GP-Golden-9/GP/docs/design_notes/rplidar_a1m8_map_quality_report.md

# RPLIDAR A1M8 Map Quality Issues: Root Causes, Community Solutions & Best Practices

**Prepared for:** Robotics / ROS Developer  
**LiDAR Model:** Slamtec RPLIDAR A1M8  
**Scope:** 2D SLAM mapping, odometry integration, dashboard visualization  

---

## Executive Summary

The RPLIDAR A1M8 is a cost-effective 360° 2D laser scanner widely used in ROS-based robotics projects. However, users frequently encounter poor map quality — distorted walls, doubled lines, blurry or "melted" obstacles — especially when the generated map is loaded on a remote dashboard or a separate laptop. This report documents the root causes of these issues, the solutions successfully applied by the ROS community, and best practices for achieving high-quality, stable maps with the A1M8.

---

## 1. Hardware Specifications (A1M8)

Understanding hardware limits is critical before tuning software parameters[cite:16][cite:30].

| Parameter | Specification |
|---|---|
| Ranging Method | Laser Triangulation |
| Scan Rate | 5.5 Hz (default), configurable up to 10–16 Hz |
| Sample Frequency | ≥ 8,000 Hz |
| Angular Resolution | ≤ 1° |
| Distance Range | 0.15 – 12 m (R5 model); 0.15 – 6 m (R4 and below) |
| Ranging Accuracy | < 0.5 mm / < 1% of distance |
| Communication | UART / USB (via CP2102 adapter) |

The A1M8 has **no built-in odometry**. It outputs only raw scan (`/scan`) topic data[cite:16]. This is the single most important hardware constraint that causes poor map quality.

---

## 2. Root Causes of Poor Map Quality

### 2.1 Missing or Incorrect Odometry (Primary Cause)

All major SLAM algorithms except Hector SLAM require an odometry source published to `/odom`[cite:52]. When the robot moves and SLAM has no odometry reference, it cannot correctly stitch consecutive laser scans together. The result is:

- Walls that appear doubled or smeared
- Rooms that appear stretched or rotated
- Inconsistent overlap between scan sweeps

This is the most commonly reported issue in the ROS community with the A1M8[cite:43][cite:71]. The A1M8 ships without wheel encoders or an IMU, meaning that out of the box, there is zero odometry data unless the developer provides an external source or uses a SLAM algorithm that does not require it.

### 2.2 Incorrect TF (Transform) Tree

ROS requires a complete transformation chain: `map → odom → base_link → laser_frame`[cite:38][cite:75]. When the map is viewed in RViz on the robot's own machine, RViz can source transforms locally. When the same map is loaded on a separate dashboard laptop, the TF tree is often missing or incomplete, causing the map to render incorrectly — appearing distorted, misaligned, or empty[cite:43][cite:52].

### 2.3 Laser Frame Orientation Error

If the laser is mounted in a non-standard orientation or the URDF/static TF does not correctly describe the sensor's position relative to `base_link`, the resulting scans are projected into the map at wrong angles[cite:54]. This causes the map to appear mirrored, rotated, or warped. The A1M8 scan data can also appear reversed (left/right and front/back swapped) if the frame has no rotation correction[cite:54].

### 2.4 Low Scan Frequency / Motor Speed

The A1M8's default scan rate is 5.5 Hz[cite:16][cite:60]. A higher scan rate produces more data points per unit of robot movement, resulting in better scan-to-scan matching and a cleaner map. If the motor PWM is not correctly set, the scan rate can drop below 5 Hz, producing sparse, low-quality data[cite:73][cite:60].

### 2.5 Poor SLAM Parameter Tuning

Default SLAM parameters (GMapping, slam_toolbox) are designed for generic robots with known odometry. With the A1M8 and no odometry, many defaults produce poor results[cite:74][cite:77]:

- `delta` (map resolution) defaulting to 0.05m is too coarse for small indoor rooms
- `maxUrange` not tuned to the actual sensor range causes noise injection
- `linearUpdate` and `angularUpdate` values that are too large cause infrequent map updates, making the map appear discontinuous

---

## 3. SLAM Algorithm Comparison for A1M8

Different SLAM algorithms handle the lack of odometry differently[cite:67][cite:72][cite:29].

| SLAM Algorithm | Requires Odometry | Map Quality (No Odom) | CPU Usage | Best Use Case |
|---|---|---|---|---|
| **Hector SLAM** | ❌ No | ✅ Good | Medium | No encoders, handheld or simple robots |
| **GMapping** | ✅ Yes | ❌ Very Poor | Low | Robots with wheel encoders |
| **slam_toolbox** | ✅ Yes (or rf2o) | ⚠️ Mediocre without odom | Medium-High | ROS2, robots with odometry or rf2o |
| **Google Cartographer** | ⚠️ Optional | ✅ Excellent | High | High-end hardware, RPi not ideal |
| **Karto SLAM** | ✅ Yes | ⚠️ Average | Medium | Similar to GMapping with better loop closure |

**Conclusion from the community:** For the A1M8 with no odometry source, **Hector SLAM is the most reliable choice**[cite:29][cite:67]. For ROS2 users with slam_toolbox, pairing with `rf2o_laser_odometry` resolves the odometry gap effectively[cite:52][cite:68].

---

## 4. Solution 1 — Hector SLAM (Recommended, No Odometry Needed)

Hector SLAM does not require wheel odometry at all — the LiDAR scan data alone is sufficient[cite:29][cite:63]. It uses scan-matching to estimate robot pose directly from consecutive laser sweeps.

### 4.1 Installation (ROS1 Noetic)

```bash
sudo apt install ros-noetic-hector-slam
```

### 4.2 Modify the Launch File

Edit `hector_slam/hector_mapping/launch/mapping_default.launch` and set the following[cite:64]:

```xml
<!-- Remove odom dependency: map directly to base_link -->
<param name="base_frame" value="base_link"/>
<param name="odom_frame" value="base_link"/>  <!-- No odom frame needed -->

<!-- Tuned scan parameters for A1M8 -->
<param name="map_resolution" value="0.025"/>   <!-- Default 0.05 is too coarse -->
<param name="map_size" value="2048"/>
<param name="map_update_distance_thresh" value="0.1"/>
<param name="map_update_angle_thresh" value="0.05"/>
<param name="laser_min_dist" value="0.15"/>
<param name="laser_max_dist" value="12.0"/>   <!-- 6.0 for R4 models -->
<param name="use_tf_scan_transformation" value="true"/>
<param name="use_tf_pose_start_estimate" value="false"/>
<param name="pub_map_odom_transform" value="true"/>
```

### 4.3 Static TF for Laser Frame

```bash
rosrun tf2_ros static_transform_publisher 0 0 0.1 0 0 0 base_link laser
```

If the map appears mirrored or rotated, add a π rotation[cite:54]:

```bash
rosrun tf2_ros static_transform_publisher 0 0 0.1 0 0 3.14159 base_link laser
```

### 4.4 Full Launch Sequence

```bash
# Terminal 1: Start RPLIDAR
roslaunch rplidar_ros rplidar_a1.launch

# Terminal 2: Start Hector SLAM
roslaunch hector_slam_launch tutorial.launch

# Terminal 3: Save the map
rosrun map_server map_saver -f ~/maps/my_room_map
```

---

## 5. Solution 2 — slam_toolbox + rf2o (ROS2 Recommended)

For ROS2 users, `slam_toolbox` is the standard choice but requires odometry. The `rf2o_laser_odometry` package computes odometry directly from consecutive laser scans — no encoders or IMU needed[cite:68][cite:70].

### 5.1 How rf2o Works

RF2O (Range Flow-based 2D Odometry) formulates a range flow constraint equation for every scanned point in terms of sensor velocity. It performs dense scan alignment based on scan gradients — similar to dense visual odometry — and publishes the result to `/odom`[cite:68][cite:70].

### 5.2 Installation

```bash
sudo apt install ros-humble-rf2o-laser-odometry
sudo apt install ros-humble-slam-toolbox
```

### 5.3 Launch Sequence (ROS2 Humble)

```bash
# Terminal 1: RPLIDAR driver
ros2 launch rplidar_ros rplidar_a1_launch.py

# Terminal 2: Laser odometry (replaces wheel encoders)
ros2 launch rf2o_laser_odometry rf2o_laser_odometry.launch.py \
  laser_scan_topic:=/scan \
  odom_topic:=/odom \
  base_frame_id:=base_link \
  laser_frame_id:=laser \
  freq:=10.0

# Terminal 3: SLAM Toolbox
ros2 launch slam_toolbox online_async_launch.py use_sim_time:=false

# Terminal 4: Save the map
ros2 run nav2_map_server map_saver_cli -f ~/maps/my_room_map \
  --ros-args -p save_map_timeout:=5.0
```

---

## 6. Solution 3 — GMapping with Tuned Parameters

If wheel encoders are available, GMapping can produce excellent results with proper parameter tuning[cite:74][cite:77][cite:42].

### 6.1 Optimized Parameters for A1M8

```xml
<!-- In rplidar_gmapping.launch -->
<param name="map_update_interval" value="2.0"/>   <!-- Faster map updates -->
<param name="maxUrange"           value="6.0"/>   <!-- Match sensor range -->
<param name="maxRange"            value="8.0"/>
<param name="delta"               value="0.025"/> <!-- Higher resolution than default 0.05 -->
<param name="minimumScore"        value="50"/>
<param name="linearUpdate"        value="0.1"/>   <!-- Update more frequently -->
<param name="angularUpdate"       value="0.1"/>
<param name="temporalUpdate"      value="3.0"/>
<param name="particles"           value="80"/>
<param name="srr"                 value="0.01"/>
<param name="srt"                 value="0.02"/>
<param name="str"                 value="0.01"/>
<param name="lskip"               value="10"/>
<param name="xmin"  value="-10"/> <param name="xmax" value="10"/>
<param name="ymin"  value="-10"/> <param name="ymax" value="10"/>
```

---

## 7. Solution 4 — Fix Map Display on Remote Dashboard

When the map is saved and then loaded on a separate laptop (dashboard), common display issues occur because the TF tree and SLAM context no longer exist on that machine.

### 7.1 Required Static Transforms on Dashboard Laptop

```bash
# Publish a static map→odom transform so the map renders in place
ros2 run tf2_ros static_transform_publisher 0 0 0 0 0 0 map odom

# Publish odom→base_link
ros2 run tf2_ros static_transform_publisher 0 0 0 0 0 0 odom base_link

# Publish base_link→laser
ros2 run tf2_ros static_transform_publisher 0 0 0.1 0 0 0 base_link laser
```

### 7.2 Map Server Launch on Dashboard

```bash
# ROS1
rosrun map_server map_server ~/maps/my_room_map.yaml

# ROS2
ros2 run nav2_map_server map_server \
  --ros-args -p yaml_filename:=~/maps/my_room_map.yaml
ros2 lifecycle set /map_server configure
ros2 lifecycle set /map_server activate
```

### 7.3 Verify the YAML File

The saved `.yaml` file must have correct parameters[cite:70]:

```yaml
image: my_room_map.pgm
resolution: 0.025         # Must match what was used during mapping
origin: [-10.0, -10.0, 0.0]
negate: 0
occupied_thresh: 0.65
free_thresh: 0.196
```

---

## 8. Scan Frequency Tuning

A higher scan frequency produces more data points per robot movement cycle and dramatically improves map quality[cite:60][cite:73][cite:78].

### 8.1 Set Motor Speed in Launch File (ROS1)

```xml
<!-- In rplidar_a1.launch -->
<param name="angle_compensate" type="bool" value="true"/>
<param name="scan_mode"        type="string" value="Sensitivity"/>
<!-- Target scan frequency: aim for 8–10 Hz -->
```

### 8.2 Set Scan Mode (ROS2)

```python
# In rplidar_a1_launch.py
parameters=[{
    'serial_port':      '/dev/ttyUSB0',
    'serial_baudrate':  115200,
    'frame_id':         'laser',
    'inverted':         False,
    'angle_compensate': True,
    'scan_mode':        'Sensitivity',  # Use 'Standard' or 'Sensitivity'
}]
```

| Scan Mode | Sample Rate | Use Case |
|---|---|---|
| Standard | ~8000 Hz / 5.5 Hz rotation | Normal indoor mapping |
| Sensitivity | ~8000 Hz / 10 Hz rotation | Better for fast robots |
| Boost | Not supported on A1M8 | A2/A3 only |

---

## 9. Community-Reported Experiences

The following table summarizes real-world solutions applied by the ROS community for A1M8 map quality issues[cite:43][cite:71][cite:52][cite:64].

| User Report | Problem | Applied Fix | Outcome |
|---|---|---|---|
| Reddit r/ROS (2025) | slam_toolbox map completely distorted | Added rf2o laser odometry, fixed TF tree | Clean map with accurate walls[cite:43] |
| LinkedIn (2025) | SLAM map warped despite parameter tweaks | Corrected odom_frame → base_link, set static TF | Distortion resolved[cite:71] |
| TheConstruct Forum (2023) | slam_toolbox not using laser for odometry | Deployed rf2o_laser_odometry package | Map quality significantly improved[cite:52] |
| Korean ROS Blog (2024) | hector_slam with A1M8 | Changed base/odom frames to base_link | Produced accurate indoor map without any encoders[cite:64] |
| ROS Answers (2023) | rplidar A1M8 mapping from scratch on ROS2 | Used Hector SLAM + corrected TF | Map and scan matched correctly[cite:63] |
| GitHub slam_toolbox issue | 360° lidar scan errors in slam_toolbox | Upgraded rplidar_ros driver | Scan stitching errors eliminated[cite:24] |

---

## 10. Troubleshooting Checklist

Use this checklist before each mapping session[cite:43][cite:52][cite:54][cite:60].

**Hardware Checks:**
- [ ] USB cable is secure; `ls /dev/ttyUSB*` confirms device presence
- [ ] Correct permissions: `sudo chmod 666 /dev/ttyUSB0`
- [ ] LiDAR motor is spinning at correct speed (listen for consistent hum)
- [ ] No obstructions within 15 cm of the sensor (min range = 0.15m)

**TF Tree Checks:**
- [ ] `ros2 run tf2_tools view_frames` shows full chain: `map → odom → base_link → laser`
- [ ] No TF warnings in terminal output
- [ ] Laser frame orientation matches physical mounting

**SLAM Configuration Checks:**
- [ ] Odometry source confirmed (rf2o, encoders, or Hector SLAM without odom)
- [ ] `map_resolution` set to 0.025m or lower
- [ ] `maxUrange` set to actual sensor range (6.0m for R4, 12.0m for R5)
- [ ] `linearUpdate` ≤ 0.2 and `angularUpdate` ≤ 0.2

**Movement Checks:**
- [ ] Robot moves slowly and smoothly during mapping (< 0.3 m/s recommended)
- [ ] No sudden rotations; gradual turns preferred
- [ ] Revisit areas from multiple angles to improve loop closure

**Dashboard Display Checks:**
- [ ] Static TF published on dashboard laptop: `map → odom → base_link → laser`
- [ ] Map server launched and in ACTIVE lifecycle state (ROS2)
- [ ] YAML `resolution` value matches the value used during mapping

---

## 11. Recommended Setup Summary

For the majority of A1M8 users without wheel encoders or IMU, the following stack produces the best results with the lowest complexity[cite:29][cite:52][cite:64]:

**ROS1 (Recommended):**  
`rplidar_ros` → `hector_slam` → `map_server` (save/load)

**ROS2 (Recommended):**  
`rplidar_ros` → `rf2o_laser_odometry` → `slam_toolbox` (online_async) → `nav2_map_server`

Both setups should use:
- `map_resolution: 0.025`
- `scan_mode: Sensitivity`
- Correct static TF for laser frame

---

## 12. Conclusion

Poor map quality with the RPLIDAR A1M8 is almost universally caused by three factors: missing odometry, incorrect TF configuration, and default SLAM parameters that are not tuned for the sensor's characteristics. The ROS community has converged on Hector SLAM (for odometry-free setups) and rf2o + slam_toolbox (for ROS2) as the most reliable combinations. Resolution improvements, scan frequency tuning, and correct static transforms on the dashboard machine complete the solution. Following this report's recommendations should yield clean, accurate indoor maps suitable for navigation and localization.
