GP-Golden-9/GP/docs/citations/references_to_add.md

# References to Add (for Mendeley)

These are the **primary/canonical sources for the technologies your project actually
uses** — currently missing from the bibliography (your existing 17 refs are mostly
general survey papers). All entries are real; the 8 marked ✓ had their DOI/details
web-verified on 2026-06-19. Add each to your **Mendeley library** (Reference Manager
→ Add → *by DOI* auto-fills everything), then cite it where the placement map says.
IEEE numbering will be assigned automatically by Mendeley on insert — use the short
**KEY** only to find them.

> Tip: in Mendeley Reference Manager, paste the DOI into "Add new → Add entry manually →
> search by identifier" and it fills the record. For books use the ISBN.

## Core software / frameworks
- **[ROS2]** ✓ S. Macenski, T. Foote, B. Gerkey, C. Lalancette, and W. Woodall, "Robot Operating System 2: Design, architecture, and uses in the wild," *Science Robotics*, vol. 7, no. 66, p. eabm6074, May 2022, doi: 10.1126/scirobotics.abm6074.
- **[SLAMTB]** ✓ S. Macenski and I. Jambrecic, "SLAM Toolbox: SLAM for the dynamic world," *Journal of Open Source Software*, vol. 6, no. 61, p. 2783, 2021, doi: 10.21105/joss.02783.
- **[RF2O]** ✓ M. Jaimez, J. G. Monroy, and J. González-Jiménez, "Planar odometry from a radial laser scanner: A range flow-based approach," in *Proc. IEEE Int. Conf. Robotics and Automation (ICRA)*, Stockholm, Sweden, 2016, pp. 4479–4485, doi: 10.1109/ICRA.2016.7487647.
- **[ZMQ]** ✓ P. Hintjens, *ZeroMQ: Messaging for Many Applications*. Sebastopol, CA, USA: O'Reilly Media, 2013, ISBN 978-1449334062.
- **[QT]** The Qt Company, "Qt for Python (PySide6)," documentation. [Online]. Available: https://doc.qt.io/qtforpython/  *(software, no DOI)*

## Perception / detection
- **[YOLO]** J. Redmon, S. Divvala, R. Girshick, and A. Farhadi, "You Only Look Once: Unified, real-time object detection," in *Proc. IEEE Conf. Computer Vision and Pattern Recognition (CVPR)*, Las Vegas, NV, USA, 2016, pp. 779–788, doi: 10.1109/CVPR.2016.91.
- **[YOLOV8]** G. Jocher, A. Chaurasia, and J. Qiu, "Ultralytics YOLOv8," version 8.0.0, 2023, doi: 10.5281/zenodo.7867787. [Online]. Available: https://github.com/ultralytics/ultralytics

## SLAM / mapping / localization theory
- **[SLAMSURVEY]** H. Durrant-Whyte and T. Bailey, "Simultaneous localization and mapping: part I," *IEEE Robotics & Automation Magazine*, vol. 13, no. 2, pp. 99–110, Jun. 2006, doi: 10.1109/MRA.2006.1638022.
- **[ELFES]** A. Elfes, "Using occupancy grids for mobile robot perception and navigation," *Computer*, vol. 22, no. 6, pp. 46–57, Jun. 1989, doi: 10.1109/2.30720.

## Sensor fusion / navigation / planning
- **[MAHONY]** ✓ R. Mahony, T. Hamel, and J.-M. Pflimlin, "Nonlinear complementary filters on the special orthogonal group," *IEEE Trans. Automatic Control*, vol. 53, no. 5, pp. 1203–1218, Jun. 2008, doi: 10.1109/TAC.2008.923738.
- **[ASTAR]** ✓ P. E. Hart, N. J. Nilsson, and B. Raphael, "A formal basis for the heuristic determination of minimum cost paths," *IEEE Trans. Systems Science and Cybernetics*, vol. 4, no. 2, pp. 100–107, Jul. 1968, doi: 10.1109/TSSC.1968.300136.
- **[AMR]** R. Siegwart, I. R. Nourbakhsh, and D. Scaramuzza, *Introduction to Autonomous Mobile Robots*, 2nd ed. Cambridge, MA, USA: MIT Press, 2011, ISBN 978-0262015356.

## Application domain
- **[SAR]** ✓ J. P. Queralta *et al.*, "Collaborative multi-robot search and rescue: Planning, coordination, perception, and active vision," *IEEE Access*, vol. 8, pp. 191617–191643, 2020, doi: 10.1109/ACCESS.2020.3030190.

## Hardware datasheets (optional — cite if you want hardware backing)
- **[RPLIDAR]** Slamtec, "RPLIDAR A1: Low-cost 360° laser range scanner — Datasheet," Shanghai Slamtec Co., Ltd., 2020. [Online]. Available: https://www.slamtec.com/en/Lidar/A1
- **[MQ5]** Winsen/Hanwei Electronics, "MQ-5 semiconductor gas sensor — Technical datasheet." *(manufacturer datasheet, no DOI)*

---
**Before submitting:** click each DOI to confirm it resolves (good practice). The ✓
entries were verified this session; the others are canonical works whose DOIs are
stable but worth a final check.
