GP-Golden-9/GP/docs/book_images/IMAGE_AUDIT.md

# Book Image Audit

Source: `Swarm_Robot_System_Graduation_Book_CORRECTED.docx`  |  Embedded media files: 24 (incl. duplicates)

## Required figures (List of Figures + in-text captions)

| Figure | Caption | Status | Source image |
|---|---|---|---|
| 2.1 | Main hardware components | present | image3.png (montage a-e) |
| 3.1 | Multi-robot system configuration | present | image11.png |
| 3.2 | Multi-Robot System Architecture and Communication Framework | present | image13.png |
| 3.3 | CAD model of the robot chassis | present | image15.png |
| 3.4 | Final Assembled Design of the Mapping Explorer Robot | present | image17.png |
| 3.5 | Software Stack and ROS Node Architecture | present | image18.jpeg |
| 3.6 | Native PySide6 desktop monitoring dashboard | present | image19.png |
| 3.7 | Real-Time Dashboard Interface | present | image21.png |
| 5.1 | SLAM Occupancy Grid Output vs. Physical Test Environment | MISSING -> placeholder inserted | _placeholders/figure_5.1_PLACEHOLDER.png |
| 5.2 | Dashboard Gas Concentration Heatmap Visualization | MISSING -> placeholder inserted | _placeholders/figure_5.2_PLACEHOLDER.png |

## Organized real images

- `image1.png` -> `docs/book_images/cover/cover_logo_1.png`
- `image2.png` -> `docs/book_images/cover/cover_logo_2.png`
- `image22.png` -> `docs/book_images/cover/page_header_logo.png`
- `image3.png` -> `docs/book_images/chapter2/figure_2.1_main_hardware_components_a.png`
- `image4.png` -> `docs/book_images/chapter2/figure_2.1_main_hardware_components_b.png`
- `image5.png` -> `docs/book_images/chapter2/figure_2.1_main_hardware_components_c.png`
- `image6.png` -> `docs/book_images/chapter2/figure_2.1_main_hardware_components_d.png`
- `image7.png` -> `docs/book_images/chapter2/figure_2.1_main_hardware_components_e.png`
- `image11.png` -> `docs/book_images/chapter3/figure_3.1_multi_robot_system_configuration.png`
- `image13.png` -> `docs/book_images/chapter3/figure_3.2_system_architecture_comm_framework.png`
- `image15.png` -> `docs/book_images/chapter3/figure_3.3_cad_model_robot_chassis.png`
- `image17.png` -> `docs/book_images/chapter3/figure_3.4_final_assembled_mapping_explorer.png`
- `image18.jpeg` -> `docs/book_images/chapter3/figure_3.5_software_stack_ros_node_architecture.jpeg`
- `image19.png` -> `docs/book_images/chapter3/figure_3.6_pyside6_desktop_dashboard.png`
- `image21.png` -> `docs/book_images/chapter3/figure_3.7_realtime_dashboard_interface.png`

## Duplicate / unreferenced media (kept for reference)

- `image10.png` (dup-of-primary)
- `image12.png` (dup-of-primary)
- `image14.png` (dup-of-primary)
- `image16.png` (dup-of-primary)
- `image20.png` (dup-of-primary)
- `image60.png` (dup-of-primary)
- `image70.png` (dup-of-primary)
- `image8.png` (dup-of-primary)
- `image9.png` (dup-of-primary)

## Folder layout

```
docs/book_images/
  cover/            university / project / header logos
  chapter2/         Figure 2.1 hardware montage (a-e)
  chapter3/         Figures 3.1 - 3.7
  chapter5/         Figures 5.1, 5.2 (placeholders for now)
  _placeholders/    generated placeholder PNGs + default template
  _unused_or_duplicate/  Word's duplicate copies + page-header logo
```

## Action needed from you

Provide the two real Chapter-5 figures and drop them into `chapter5/`:
- **Figure 5.1** - SLAM occupancy-grid output vs. the physical test area (screenshot the dashboard map next to a photo of the arena).
- **Figure 5.2** - dashboard gas-concentration view when the MQ-5 alarm trips.
Then tell me and I'll swap the placeholders for the real images.
