GP-Golden-9/GP/Rain's GP Book.pdf

# Rain

A Graduation Project Report Submitted
to
Faculty of Engineering, Cairo University
in Partial Fulfillment of the requirements of the degree of
Bachelor of Science in Computer Engineering.

Presented by

Mostafa Elgendy | Menna Alla Ahmed
Mostafa Wael | Nada Elsayed
Supervised by

Prof. Ihab Talkhan

July, 2023

All rights reserved. This report may not be reproduced in whole or in part, by photocopying or other means, without the permission of the authors/department.

Rain | 2023

## Abstract

This project aims to address the escalating computational demands and financial barriers associated with training powerful AI models. The problem lies in the reliance on expensive hardware investments and the limited accessibility to advanced AI training capabilities. The objective of the project is to develop Rain, a serverless solution that revolutionizes the AI landscape by providing a cost-effective and accessible approach to AI model training.

The project follows a two-fold approach. Firstly, Rain divides AI models into independent tasks, enabling efficient parallelization and distribution of workloads. Secondly, Rain provisions servers and runs these tasks on them, parallelizing the training process. The approach combines the capabilities of distributed systems, cloud engineering, and AI algorithms to optimize resource allocation, scalability, and fault tolerance.

The output of the project is Rain, a Python package released on PyPI, which offers a user-friendly interface and easy-to-use tools for training AI models. Rain supports various machine learning algorithms, including k-means, Gaussian Naive Bayes, logistic regression, and linear regression. For deep learning, Rain integrates with popular frameworks such as TensorFlow and PyTorch, handling the scaling and parallelization of deep learning workloads.

Testing and development tools used in the project include Tox for managing virtual environments and conducting tests, as well as a testing pipeline integrated with a CI/CD platform for automated testing and deployment. The testing results demonstrate the successful functioning of Rain across different modes (local, lazy, and cloud) and the accurate training outcomes achieved with various algorithms and datasets.

The project's outcomes provide a powerful solution for individuals and organizations seeking to train AI models efficiently. Students gain access to AI training capabilities without significant hardware investments, while companies optimize resource utilization and reduce infrastructure costs. Researchers and data scientists benefit from improved productivity and faster model iterations. Startups and small businesses can scale their AI capabilities without substantial financial commitments.

2 | Page

Rain | 2023

Overall, Rain democratizes AI training, fostering innovation and advancements in the field.

Through extensive testing and development, Rain proves to be a reliable and robust tool for parallelizing AI workloads. Its accessibility, scalability, and optimized resource utilization contribute to improved training outcomes and enhanced productivity.

3 | Page

Rain | 2023

## الملخص

يهدف هذا المشروع إلى معالجة االحتياجات الحسابية المتزايدة والحواجز المالية المرتبطة بتدريب نماذج الذكاء االصطناعي الضخمة. المشكلة تكمن في االعتماد على استثمارات مكلفة في األجهزة والتحديات في الوصول إلى القدرات المطلوبة لتدريب نماذج متقدمة و ضخمة للذكاء االصطناعي. هدف المشروع هو تطوير مكتبة ” مطر“ كحل خادم بال خادم كي يحدث ثورة في مجال الذكاء االصطناعي من خالل توفير نهج ف ّعال من حيث التكلفة وسهولة الوصول لتدريب نماذج الذكاء االصطناعي

يقوم بتقسيم نماذج الذكاء االصطناعي إلى مهام مستقلة مما يتيح التوازي الفعال | يتبع المشروع نه ًجا مزدو ًجا. ،

أوالً
وتوزيع األعباء. ثانًيا، توفر مكتبة ” مطر” خوادم و تقوم بتشغيل هذه المهام عليها، مما يوازن عملية التدريب. يجمع هذا النهج بين إمكانيات األنظمة الموزعة وهندسة السحابة و خوارزميات الذكاء االصطناعي لتحسين توزيع الموارد وقابلية التوسع ومقاومة األخطاء

نتاج المشروع هو، مكتبة ” مطر“ : وهو حزمة برمجية بايثون متاحة على ”باي باي“ ، والتي توفر واجهة سهلة االستخدام وأدوات سهلة االستخدام لتدريب نماذج الذكاء االصطناعي. ” مطر ” يدعم مختلف خوارزميات التعلم اآللي، بما في ذلك القيم المتوسطة، واالحتمال البايز النمطي الكاوسي، والتحّول اللوجستي، والتحّول الخطي. بالنسبة للتعلم العميق، يتكامل "مطر" مع اإلطارات المشهورة مثل ”باي تورش“ و ” تنسورفلو“، ويتعامل مع توزيع وتوازن األعباء

للتعلم العميق

تشمل أدوات االختبار والتطوير المستخدمة في المشروع إلدارة البيئات االفتراضية وإجراء االختبارات مثل ” توكس“، باإلضافة إلى خط إنتاج االختبار المتكامل مع منصة االختبار والنشر التلقائى ” سي أي سي دي ” . تظهر نتائج االختبارات ” مطر“ النجاح في عمل عبر وضعيات مختلفة )محلية وكسولة سحابية( وتحقيق نتائج تدريب دقيقة باستخدام مختلف الخوارزميات ومجموعات البيانات

قوًيا لألفراد والمؤسسات الساعية لتدريب نماذج الذكاء االصطناعي بكفاءة. يحصل الطالب | تقدم نتائج المشروع

حالً
على وصول إلى قدرات تدريب الذكاء االصطناعي دون الحاجة الستثمارات كبيرة في األجهزة، بينما تقوم الشركات بتحسين استخدام الموارد وتقليل تكاليف البنية التحتية. يستفيد الباحثون وعلماء البيانات من زيادة اإلنتاجية وسرعة التطوير للنماذج. يمكن للشركات الناشئة واألعمال الصغيرة توسيع قدراتها في مجال الذكاء االصطناعي بدون التزامات مالية كبيرة. بشكل عام، يجعل ” مطر ” التدريب في مجال الذكاء االصطناعي متا ًحا للجميع، مما يعزز االبتكار .والتطور في هذا المجال

من خالل االختبارات والتطوير المكثف، يثبت ” مطر ” أنه أداة موثوقة وقوية لتوزيع األعباء العملية في الذكاء االصطناعي. سهولة الوصول والقابلية للتوسع واستخدام الموارد المح َّسن ُيسهم في تحسين نتائج التدريب وزيادة
اإلنتاجية
4 | Page

Rain | 2023

## ACKNOWLEDGMENT

We would like to extend our sincere appreciation and gratitude to all those who have contributed to the successful completion of this graduation project especially to our esteemed professor, Prof. Ihab Talkhan, for their invaluable guidance, mentorship, and unwavering support throughout our five-year academic journey. Their profound knowledge, expertise, and commitment to excellence have been instrumental in shaping our developing skills and nurturing our intellectual growth.

We would also like to extend our gratitude to the distinguished doctors who have generously shared their wisdom and expertise with us over the years. Their lectures, seminars, and interactive discussions have enriched our understanding of the subject matter, broadened our horizons, and sparked our curiosity to explore further. Their dedication to imparting knowledge and nurturing young minds has been truly inspiring, and we are indebted to them for their contributions to our education.

Finally, we would like to thank our families and loved ones for their unwavering support, patience, and understanding. Their encouragement, sacrifices, and belief in our abilities have been the driving force behind our pursuit of knowledge and personal growth.

In conclusion, the successful completion of this graduation project would not have been possible without the contributions of the aforementioned individuals and the countless others who have influenced our academic journey. Their collective efforts have shaped our intellectual development and prepared us to embrace the challenges that lie ahead. We are truly grateful for their guidance, mentorship, and unwavering support.

Sincere,

Mostafa Elgendy, Mostafa Wael, Menna Ahmed, and Nada Elsayed

Faculty of Engineering, Cairo University

July, 2023

5 | Page

Rain | 2023
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
