GP-Golden-9/GP/docs/book_images/chapter3/figure_3.1_multi_robot_system_configuration.png

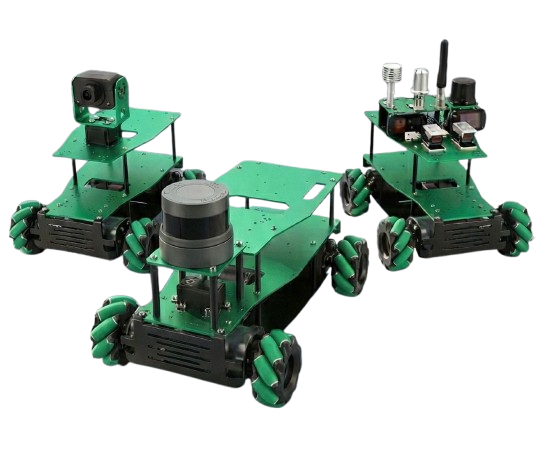
docs/book_images/chapter3/figure_3.1_multi_robot_system_configuration.png
