GP-Golden-9/GP/docs/book_images/chapter3/figure_3.2_system_architecture_comm_framework.png

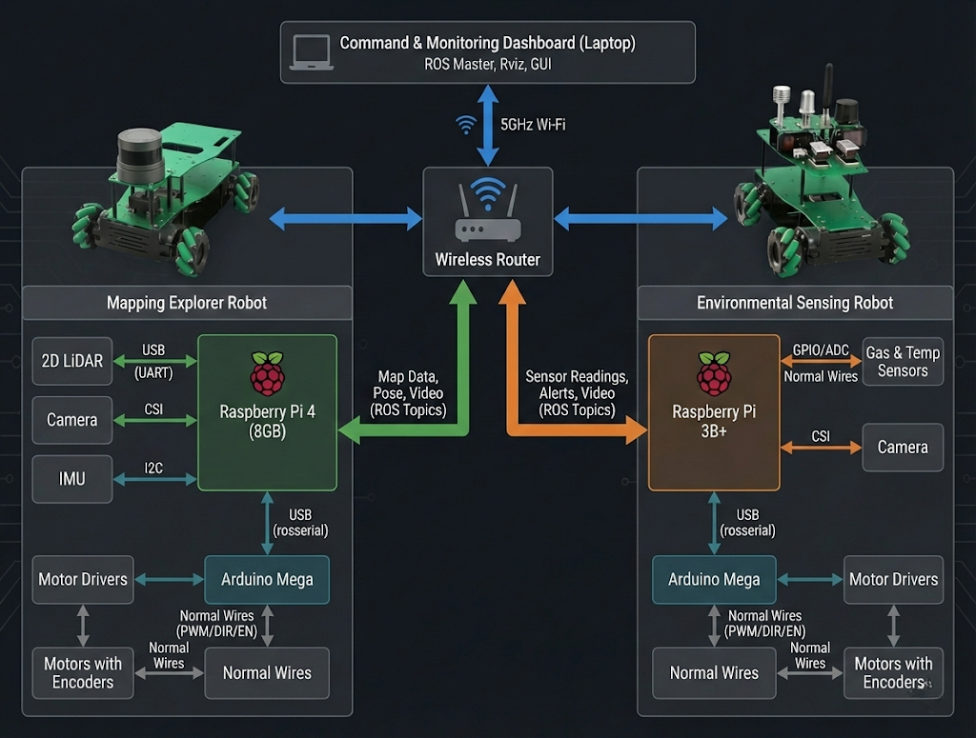
docs/book_images/chapter3/figure_3.2_system_architecture_comm_framework.png
