GP-Golden-9/GP/docs/book_images/chapter3/figure_3.3_cad_model_robot_chassis.png

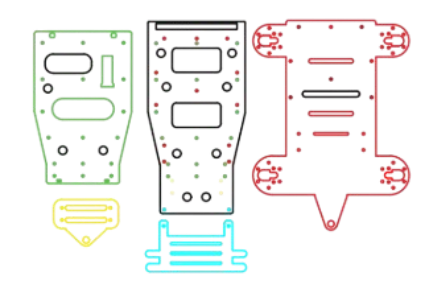
docs/book_images/chapter3/figure_3.3_cad_model_robot_chassis.png
