GP-Golden-9/GP/docs/book_images/chapter3/figure_3.5_software_stack_ros_node_architecture.jpeg

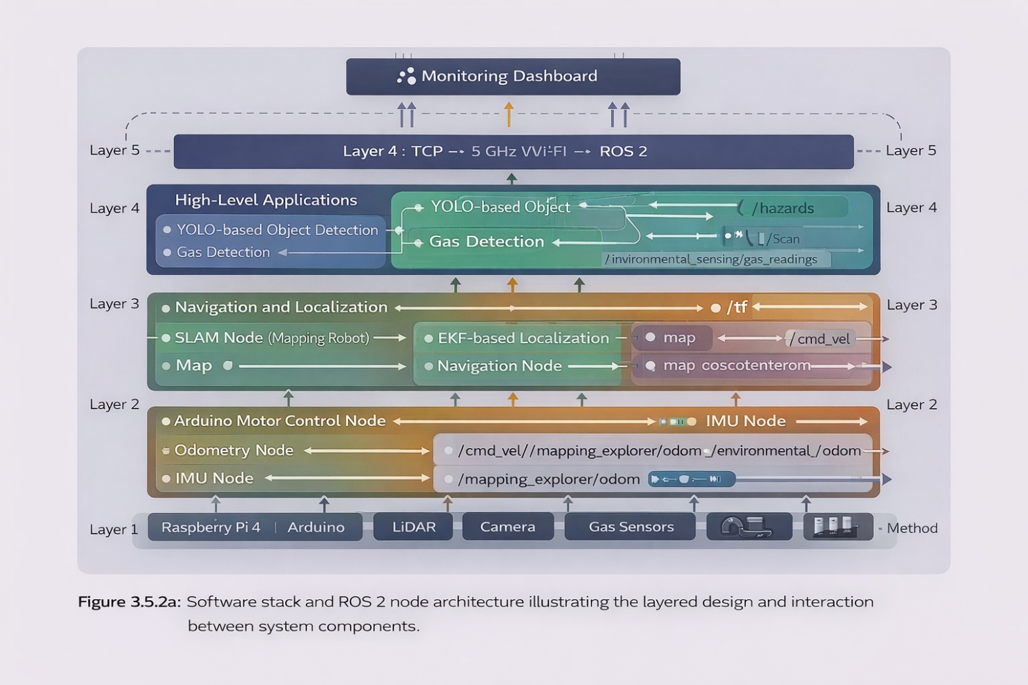
docs/book_images/chapter3/figure_3.5_software_stack_ros_node_architecture.jpeg
