GP-Golden-9/GP/docs/book_images/chapter3/figure_3.6_pyside6_desktop_dashboard.png

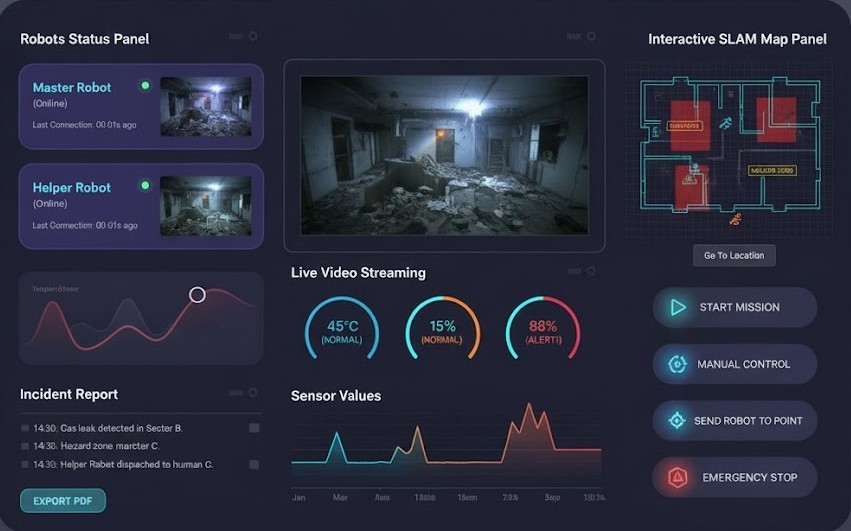
docs/book_images/chapter3/figure_3.6_pyside6_desktop_dashboard.png
