GP-Golden-9/GP/figures_png/slam_vs_environment.png

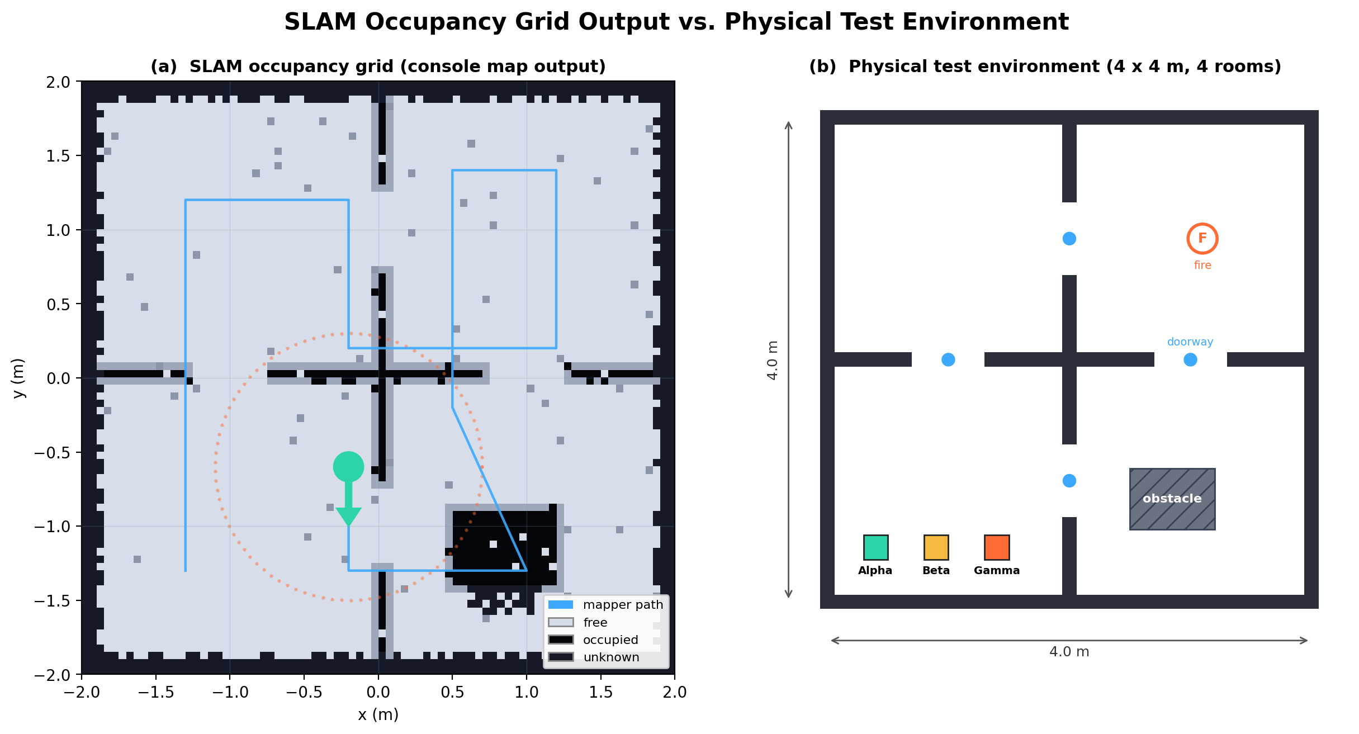
figures_png/slam_vs_environment.png
