GP-Golden-9/GP/fire.jpg

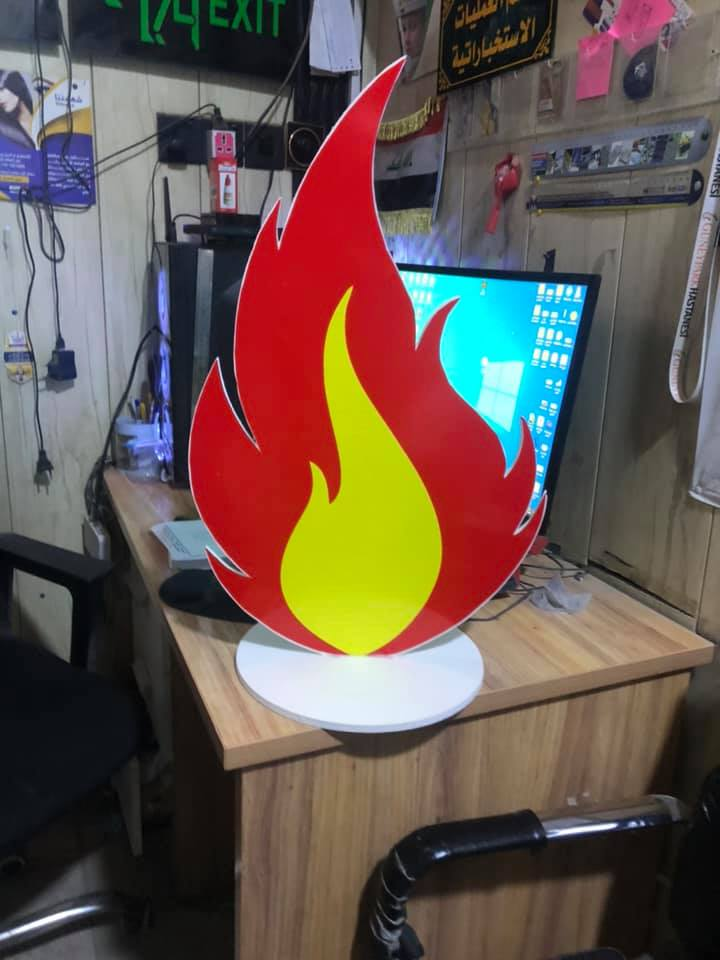
fire.jpg
