GP-Golden-9/GP/human.webp

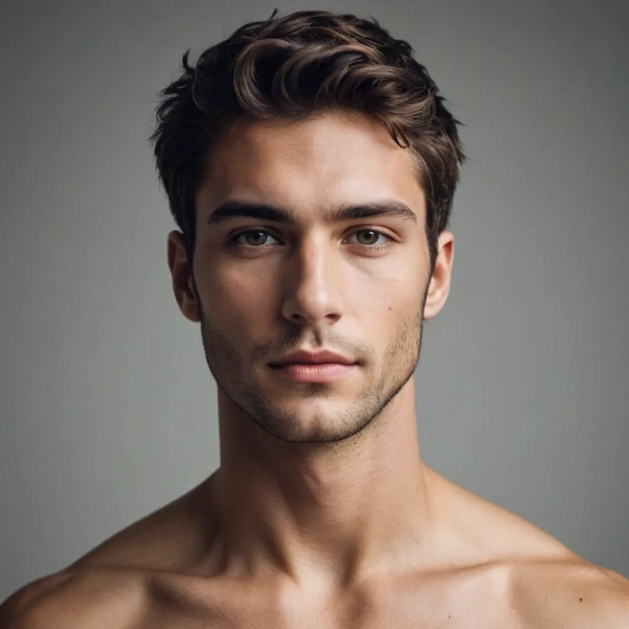
human.webp
