GP-Golden-9/GP/docs/book_images/chapter2/figure_2.1_main_hardware_components_c.png

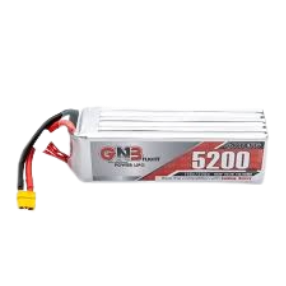
docs/book_images/chapter2/figure_2.1_main_hardware_components_c.png
