GP-Golden-9/GP/docs/book_images/chapter3/figure_3.4_final_assembled_mapping_explorer.png

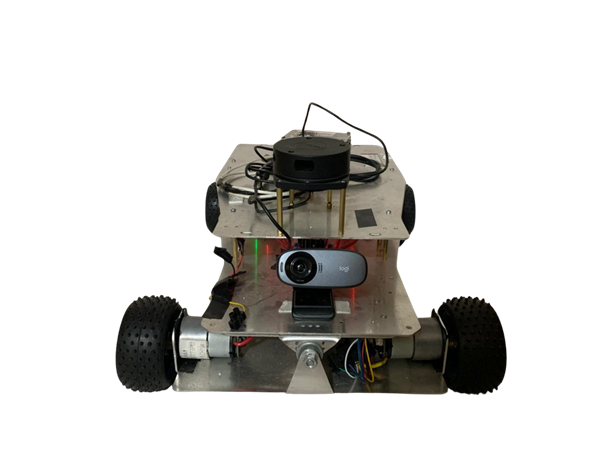
docs/book_images/chapter3/figure_3.4_final_assembled_mapping_explorer.png
