GP-Golden-9/GP/docs/field_fixes_and_runbook_2026-06-18.md

# GP — Field Fixes & Runbook (through 2026-06-18)

For the team. Everything we hit on Beta/Alpha, the root cause, and the fix —
plus how to run the autonomous FIRE TEST and how to deploy. **No secrets
here** (SSH/WiFi/OTA creds live in the gitignored `config_secrets.h`).

---

## TL;DR — what changed and how to run

- Console **AUTONOMY** dock (right side, map stays visible): two independent
  real actions on Beta — **SCAN AREA** (cover Alpha's map, return to base) and
  **GO TO FIRE -> PUMP 5s -> RETURN**.
- Major bugs fixed: wall-crashes from serial lag, ~45 deg yaw drift, the ~30 s
  motor-stall lock-up, the ~3 min slow boot.
- **One hardware thing still matters most:** the GY-87 IMU is on a marginal
  3.3 V feed and drops out intermittently → **rewire VCC to 5 V before the
  demo.** A power-cycle revives it temporarily (and the bridge now falls back
  to encoder-heading during a dropout so driven turns keep working).

### Run the AUTONOMY demo  (see the dedicated section below)
1. **Alpha** maps the area (drive it, or arm AUTONOMOUS) until the map covers
   the arena and stops changing. Leave Alpha's stack running (don't restart —
   that clears the map).
2. Select **Beta** → **SET POSE** it (press where it is, drag toward its
   heading). Required — Beta has no lidar/compass.
3. **AUTONOMY** dock → **SCAN AREA** (survey) and/or **PLACE FIRE** + **GO TO
   FIRE**. STOP (panel) or Esc (e-stop) any time.

---

## Errors we hit and how they're fixed

### 1. Beta drives into walls "fine for a minute, then crashes"
- **Cause:** the bridge serial reader processed every 50 Hz packet FIFO; on a
  loaded Pi it fell behind, the kernel serial buffer filled, and every read
  returned **seconds-old** data — so the obstacle guard saw a wall that was
  already hit, and the heading integrated stale gyro.
- **Fix:** `robot2_bridge._serial_reader` now **drains to the latest packet**
  each pass (drops stale ones; encoders are cumulative so no odometry is
  lost). Latency is bounded to one cycle. Watch for `SERIAL BACKLOG: skipped N`
  in the log — that's the fix *working*, not a fault.

### 2. Yaw drift (~45°, then ~25° after calibration)
- **Cause A:** heading was integrated on the laptop at ~20 Hz from telemetry
  that gets thinned/jittered — integrating an angular *rate* with dropped
  samples loses angle on every turn.
- **Fix A:** heading is now integrated **in the bridge at 50 Hz using the
  Mega's own `ts` timestamp** (immune to CPU/serial jitter), shipped in the
  IMU orientation; the gateway forwards it; the laptop uses it directly.
- **Cause B:** the MPU6050's per-unit scale tolerance (~3%) — drift
  proportional to *rotation*, not time.
- **Fix B:** `drive.gyro_scale_correction: 1.0304` (measured with
  `tools/yaw_calib.py`, 3 turns: 1048° read for 1080° actual). To re-measure
  on another robot: `python tools/yaw_calib.py <robot-ip> 1080`, rotate 3
  slow full turns, paste the printed factor into `config/robotN.yaml`.

### 3. The ~30-second motor-stall LOCK-UP (lost manual + auto control)
- **Cause:** a stalled DC motor pulls near locked-rotor current → the rail
  sags → the Pi browns out / throttles to 600 MHz → the bridge/gateway crawl
  → commands queue for ~30 s. An **undervoltage cascade**, not a code loop.
- **Fix:** `robot2_bridge` **stall-disarm** — when the wheels stay frozen
  under a drive command for `drive.stall_disarm_s` (3.0 s), it **kills the
  motors** and blocks re-issuing the **same** direction for
  `stall_cooldown_s` (2 s); a **different** direction is allowed immediately
  so you can escape. Re-arms each cooldown. Works for manual AND auto.
- **Escape (auto):** `robot2_local_nav` subscribes `/stall` → **reverse +
  reorient** to the more-open side (fires even when ultrasonics read clear —
  a low obstacle or high-centred). After 4 stalls in 20 s it gives up
  (`STUCK`) rather than grind forever.
- If the lock-up ever returns, the rail can't hold 3 s of stall current —
  lower `stall_disarm_s` toward 1.5 and/or fix the power (caps + buck).

### 4. ~3-minute slow boot
- **Cause:** the systemd units waited on `network-online.target`
  (NetworkManager-wait-online, ~120 s timeout) — pointless for a
  localhost-only stack.
- **Fix:** removed `network-online.target` from
  `gp-robot{1,2}` / `gp-preflight` / `gp-camera`. Boot is now ~1 min.

### 5. "It rotates in real life but the map arrow is static" → IMU dropout
- **Cause:** the GY-87 dropped off the I2C bus; firmware `mpuRead()` fails
  silently and **streams the last-good values FROZEN** (identical every
  frame, and *non-zero*, so the all-zero dead-detector misses it). No live
  rotation → frozen heading → static arrow.
- **Diagnose:** `python tools/yaw_calib.py <ip>` (or watch the heading) while
  rotating — if `gz` never spikes past ~1 rad/s, the gyro is dead/frozen.
- **Fix now:** **power-cycle the robot** (re-inits + recalibrates the MPU).
  Confirmed working after a power-cycle (peak |gz| 1.65 rad/s, heading
  tracked 360°).
- **Fix for good:** rewire the GY-87 **VCC 3.3 V → 5 V** and resolder. The
  3.3 V pin is marginal; it *will* drop again until this is done.

### 6. DDS "gateway ACKs but robot never moves" (earlier session, kept)
- **Cause:** `ROS_LOCALHOST_ONLY=1` interface tracking silently killed all
  local DDS delivery on a flaky WiFi state change.
- **Fix:** isolation moved to the transport — `interfaceWhiteList 127.0.0.1`
  in `config/fastdds_udp_only.xml`, `ROS_LOCALHOST_ONLY=0`, localhost
  discovery server, distinct domains. NOTE: the `ros2` CLI is **blind in
  discovery-server mode** — debug with the bridge's arrival logs + gateway
  freshness, not `ros2 topic`.

---

## Autonomy demo — SCAN + FIRE (added 2026-06-19)

Two independent operator-triggered actions in the **AUTONOMY** dock, both real
on Beta. Console-brokered (the laptop is the coordinator; the robots are
isolated ROS islands by design — no direct robot-to-robot link).

**SCAN AREA** — Beta surveys the mapped area:
- The console turns Alpha's map into a **coverage path** (boustrophedon /
  lawnmower) — `dashboard_qt/ui/map/coverage.py`. It ERODES the free space by
  the robot's clearance (no waypoint against a wall), uses each row's LARGEST
  open run (never crosses a gap), treats UNKNOWN cells as blocked, and CAPS the
  path at ~14 waypoints (auto-widens lanes) so it's a simple handful of sweeps.
- Beta follows it as a **reference, not a rail**: the laptop streams a heading
  bias toward the next waypoint; Beta's `robot2_local_nav` fuses it with
  ultrasonic repulsion → it deviates around unmapped obstacles and merges back.
  The dashed reference line stays on the map; the panel shows "DEVIATING" when
  it dodges.
- **Loose, progress-based following:** a waypoint is skipped only when Beta
  stops getting CLOSER to it (genuinely blocked) — NOT just because it hasn't
  arrived yet (that false-"stuck" a big map). Gives up after 4 consecutive
  unreachable waypoints. Then returns to base.

**GO TO FIRE -> PUMP 5s -> RETURN** — place a FIRE/PIN marker, then Beta
navigates to it (A* + ultrasonic dodge), holds and pumps exactly 5 s (firmware
also hard-caps), and returns to its start pose. FIRE follows precisely (no
skipping — it must reach the fire).

**Prereqs (both):** Alpha's map showing in the console + Beta SET-POSE aligned.
The panel refuses with a clear reason otherwise.

### Robust-motion knobs (config/robot2.yaml unless noted)
- `drive.auto_turn_pwm` 235, `goto.max_angular_rps` 0.35 — auto turn speed
  (raised from 200/0.25 for snappier pivots; the speed slider scales it).
- `drive.ramp_pwm_per_s` 300 — accel limit (gentle launches, anti-slip).
- `drive.stall_disarm_s` 3.0 / `stall_cooldown_s` 2.0 — the anti-lockup.
- Stall escape (local_nav): reverse -> pivot -> COMMIT FORWARD to clear the
  obstacle before re-seeking the goal (breaks the pivot-in-place trap);
  alternates direction on repeats.
- Coverage tuning is in `_scan_area` (lane_m 0.6, clearance, max_waypoints 14)
  and `mission.py` (skip_stuck, wp_timeout 12 s no-progress, tol 0.45 m).

### UI notes
- AUTONOMY is a right-side DOCK (tabbed with OPERATIONS) — the MAP stays
  visible while you run it.
- LIVE FEED falls back to **Beta's camera** when the active robot (e.g. Alpha)
  has no camera.

### SCAN "stuck with nothing in front of it" — fixed (2026-06-20, commit 63df654)

A long debug of SCAN stopping mid-sweep (in `--sim`) turned up five issues.
**Two change real Beta's behaviour — both are improvements** — so this is in
the runbook, not just a sim note. Found by instrumenting the live sim and
reproducing each cause with a headless ZMQ operator.

**Real-robot fixes (shared code — deploy to Beta to get them):**
1. **`navigation/local_nav_math.py` `goal_fusion`** — forward speed is now
   gated by the **more-OPEN** ultrasonic (min closeness), not the nearer wall.
   A wall on ONE side (a doorway, or driving alongside a wall) no longer
   freezes Beta in a potential-field local minimum — it keeps moving and steers
   clear. Forward stops only when BOTH sides are blocked (a real head-on wall).
   This is what made Beta "stop with nothing in front of it" at doorways. The
   on-robot reverse/pivot escape ladder is unchanged; the ultrasonic hard-stop
   (25 cm) and firmware guard still back it up.
2. **`dashboard_qt/ui/mission.py`** — the no-progress "stuck" check now counts
   **turning toward a waypoint** as progress, not only closing distance. With
   the gentle autonomy gains (`goto.kp_angle 0.8`, `max_angular_rps 0.35`) a
   rotate-then-drive turn keeps `vx=0` while it pivots; the old distance-only
   check called that "stuck". Now only a robot that can neither get closer NOR
   turn toward the goal is flagged.

**Console-only fix:**
3. **`dashboard_qt/ui/main_window.py`** — SCAN now plans **A\* between the
   coverage waypoints** (`_route_through`) so room-to-room transits route
   THROUGH doorways. Before, the raw coverage skeleton was handed to the
   bias-follower, which steered straight at interior walls. (FIRE already used
   A*; that's why FIRE worked and SCAN didn't.) Nav events also mirror to the
   structured log now, so `--sim` shows WHY a run stopped.

**Sim-faithfulness fixes (no robot impact, but needed to trust `--sim`):**
4. `dashboard_qt/sim/fake_gateway.py` paces physics to the **real wall clock**
   (it was stepping a fixed 0.02 s per loop and ran 2-3x real time, which
   inflated control latency and oscillated the follower around waypoints).
5. `fake_gateway` now ports `robot2_local_nav`'s **reverse → pivot →
   commit-forward** corner-escape, so the sim backs out of corners like the
   real robot (it previously only pivoted in place and pinned itself).

**Operator tip:** SET POSE accuracy matters. If you place Beta at the wrong
spot/heading, the whole coverage path maps to the wrong rooms and it can drive
into a corner. Put the marker where Beta really is and drag toward its real
heading.

**Verification:** a headless operator driving the real gateway over ZMQ (real
100 ms control latency, adversarial start heading) completes 15/15 SCAN
waypoints, 0 skips. `python -m pytest tests -q` = 114 pass (incl. new
`test_one_side_open_keeps_moving`).

**To get #1 on Beta:** it's robot-side (`robot2_local_nav` imports
`local_nav_math`) → bundle-deploy + `sudo systemctl restart gp-robot2`
(no unit change, so no `install_systemd.sh`). #2 and #3 are laptop-side
(console only). See the deploy section below.

### Operator autonomy controls — SCAN is plan → review/edit → START (2026-06-20)

All console-side (just run the dashboard — no robot redeploy). The fusion fix
above IS deployed to Beta.

- **SCAN AREA = PLAN, it does NOT move.** It shows the suggested path as
  draggable, numbered **nodes** (green START / orange END) plus the dashed A*
  route. Review/edit, then **START SCAN** drives it. **CANCEL** / **RE-PLAN**
  too. Nothing moves until START.
- **EDIT PATH** (map toolbar, or the nodes shown by SCAN): **drag** a node to
  move · **click** empty map to add (splits the nearest segment) · **right-click**
  a node to remove. The dashed A* route re-plans live around obstacles — a
  walled-off node is dropped, never connected by a straight line through a wall.
- **Manual ASSIST mid-run:** grab the joystick/WASD during SCAN/FIRE → it
  PAUSES (status "MANUAL ASSIST"), you hand-drive past a snag, and it RESUMES
  from the new pose ~1 s after you let go (no cancelling the run). Esc/E-stop
  still fully stops.
- **Decisive turn-around:** when the next node is behind, Beta commits to one
  spin direction and rotates to face it before driving (no rock-at-180°).
- **Wide-open routing + drift tolerance:** A* prefers the centre of open space
  (away from walls); the planner frees a disc around Beta's own cell so a
  lidar-less, drifted pose that reads "in a wall" doesn't block planning; on a
  true NO PATH, Beta heads for a single goal reactively (ultrasonics = reality,
  a real wall still stops it at 25 cm).
- **Known limit:** the forward/back oscillation that can still appear right
  next to a wall is the ON-ROBOT escape ladder (`robot2_local_nav`), not the
  console. Grab the NAV LOG if it persists and tune the ladder there.

## Deploying to the robots

Units live in `/etc/systemd/system` — a plain `git pull` does NOT update them.
For a systemd/unit change, after pulling run:
`sudo bash systemd/install_systemd.sh robotN ~/GP` (or `tools/deploy_and_verify.sh robotN`).

### Beta has no GitHub internet → deploy by git BUNDLE over the LAN
```
# on the laptop (BASE must be Beta's actual HEAD — its origin/main is stale):
git bundle create ~/gp.bundle <beta-HEAD>..main
scp ~/gp.bundle muc@<beta-ip>:~/         # NOT /tmp (it's a 50 MB full tmpfs)
# on Beta:
cd ~/GP && git fetch ~/gp.bundle main && git merge --ff-only FETCH_HEAD
sudo systemctl restart gp-robot2
```
Alpha (`robot.local`) usually has working internet → normal `git pull`.

---

## Architecture notes (so the team isn't surprised)

- **Odometry runs on the LAPTOP** now (`dashboard_qt/state/local_odom.py`),
  not the Pi — it reconstructs Beta's pose from telemetry (enc+gyro+heading).
  This freed ~80 % of a Pi core; Beta's launch runs ONE reactive node
  (`robot2_local_nav.py`).
- **The map link is via the laptop**, by design: ROS islands are isolated, so
  the console holds Alpha's map and plans Beta's global A* route, streaming
  Beta a simple `/cmd_vel_bias` it fuses with its ultrasonics. No fragile
  robot-to-robot map link.
- **Smooth/odometry-safe motion** is tuned conservative (config: turn ≤
  0.25 rad/s, lin ≤ 0.12 m/s, gentle 300 PWM/s accel ramp) to avoid wheel
  slip that corrupts the yaw.

---

## Open hardware tickets (do before the demo)
1. **GY-87 IMU: VCC 3.3 V → 5 V + resolder** (highest priority — it drops out).
2. Alpha: cable/bracket in the lidar plane on the left flank — tuck it away.
3. Heatsinks on the Pis (Beta has run warm).
4. VBUS backpower: the Mega backfeeds the Pi over USB — tape over VBUS or a
   master switch; SHUTDOWN from the console first, then cut power.
5. Re-measure robot2 track width with a 360° spin if pivots over/under-rotate.

## Handy tools
- `tools/yaw_calib.py <ip> [deg]` — measure the gyro scale factor.
- `tools/deploy_and_verify.sh robotN` — pull + reinstall units + restart + show boot chain.
- `tools/fleet_healthcheck.py`, `tools/collect_logs.py` — diagnostics.
