GP-Golden-9/GP/config/robot1.yaml

# Robot 1 "Alpha" — the Mapper (Pi 4 + Mega + RPLidar A1)
robot:
  id: robot1
  name: Alpha
  host: 192.168.1.200
  kind: ros            # ros | esp32
  user: muc            # SSH user (console diagnostics / shutdown)

ros:
  domain_id: 11
  rosbridge_port: 9090   # legacy dashboard fallback

serial:
  port: /dev/mega        # udev symlink (systemd/99-gp-serial.rules)
  baud: 115200

lidar:
  port: /dev/rplidar
  min_scan_hz: 3.0       # scan_watchdog restarts the driver below this
  stall_grace_s: 5.0

zmq:
  telemetry: 5556
  map: 5557
  cmd: 5558
  health: 5559
  video: 5560            # unused on robot1 (no camera)

drive:
  max_linear_mps: 0.5
  deadman_timeout_s: 0.8
  keepalive_period_s: 0.3

explorer:
  front_safe_m: 0.50
  side_safe_m: 0.40
  emergency_m: 0.30
  corridor_width_m: 0.65
  speed_mps: 0.06
  turn_speed_rps: 0.30

# Measured chassis (2026-06-11): 40 cm long x 30 cm wide. The RPLidar A1
# (~10 cm body) sits 5 cm behind the front edge and 10 cm from each side
# rail -> its CENTER (= base_link origin, laser at identity translation)
# is 0.10 m behind the front edge and laterally centered. The lidar's 0
# deg axis faces the chassis REAR -> laser frame is yawed pi vs base_link.
footprint:
  length_m: 0.40
  width_m: 0.30
  forward_extent_m: 0.10     # base_link -> front edge
  rear_extent_m: 0.30        # base_link -> rear edge (the long overhang!)
  half_width_m: 0.15
  laser_yaw_rad: 3.14159265  # base_link -> laser rotation

goto:
  max_linear_mps: 0.15
  max_angular_rps: 0.40
  goal_tolerance_m: 0.12
  # scan-based safety (all distances from base_link):
  stop_ahead_m: 0.35         # forward extent 0.10 + 0.25 braking margin
  resume_ahead_m: 0.45       # hysteresis so it doesn't stutter at the edge
  corridor_half_m: 0.21      # half width 0.15 + 0.06 lateral margin
  rotate_clear_m: 0.36       # rear-corner sweep 0.335 + margin (rear half
                             # only — the front never reaches past 0.18)
  blocked_abort_s: 6.0       # obstacle persists this long -> goal aborted

# Water pump (relocated from Beta 2026-06-23). Alpha runs the go-to-fire ->
# pump 10 s -> return action; it has lidar so it navigates there far better
# than the lidar-less Beta. Firmware defines mirror these (robot1_controller).
accessories:
  pump:
    pin: 34              # firmware v3.1 (free pin; motors use 4-7 + 22-29)
    active_low: false    # this module is active-HIGH (ran the pump at boot when
                         # set active-low); mirror RELAY_ACTIVE_LOW in the .ino
    max_run_ms: 10000    # firmware-enforced auto-off (the fire action = 10 s)
    cooldown_ms: 1000
