GP-Golden-9/GP/navigation/robot2_bridge.py

#!/usr/bin/env python3
"""
Robot 2 (Beta) — Motor & Sensor Bridge for ROS 2
=================================================
Pairs with robot2_controller.ino (Arduino Mega)

Responsibilities:
  1. Receive movement commands from dashboard → send to Arduino
  2. Parse streaming sensor data from Arduino (50 Hz)
  3. Publish /encoders  (std_msgs/Int32MultiArray)
  4. Publish /imu/data  (sensor_msgs/Imu)
  5. Publish /motor_status (std_msgs/String) for dashboard

Serial Protocol (from Arduino):
  D:timestamp,enc1,enc2,enc3,enc4,ax,ay,az,gx,gy,gz
"""

import math
import os
import sys
import rclpy
from rclpy.node import Node
from geometry_msgs.msg import Twist
from std_msgs.msg import String, Float32, Int32MultiArray, Bool
from sensor_msgs.msg import Imu, Range
import serial
import time
import threading


# ═══════════════════════════════════════
# IMU Conversion Constants (must match Arduino config)
# ═══════════════════════════════════════
# Accel: AFS_SEL=1 → ±4g → 8192 LSB/g
ACCEL_SCALE = 9.81 / 8192.0    # raw → m/s²
# Gyro:  FS_SEL=1  → ±500°/s → 65.5 LSB/(°/s)
GYRO_SCALE = math.pi / (180.0 * 65.5)   # raw → rad/s

# Per-unit gyro scale-factor correction (config drive.gyro_scale_correction).
# Cancels the MPU6050's +/-3% sensitivity tolerance, the residual yaw drift.
sys.path.insert(0, os.path.join(os.path.dirname(os.path.abspath(__file__)),
                                '..', 'common'))
GYRO_SCALE_CORRECTION = 1.0
# Kinematics for the ENCODER-HEADING FALLBACK (used when the GY-87 drops off
# the I2C bus and the gyro freezes — driven turns still update heading).
WHEEL_DIAMETER = 0.085
TICKS_PER_REV = 408
WHEEL_BASE = 0.225
try:
    from gpcore.config import get_path, load_config
    _cfg = load_config(os.path.join(os.path.dirname(os.path.abspath(__file__)),
                                    '..', 'config', 'robot2.yaml'))
    GYRO_SCALE_CORRECTION = float(get_path(
        _cfg, 'drive.gyro_scale_correction', 1.0))
    WHEEL_DIAMETER = float(get_path(_cfg, 'drive.wheel_diameter_m', WHEEL_DIAMETER))
    TICKS_PER_REV = int(get_path(_cfg, 'drive.ticks_per_rev', TICKS_PER_REV))
    WHEEL_BASE = float(get_path(_cfg, 'drive.wheel_base_m', WHEEL_BASE))
except Exception:
    pass
METERS_PER_TICK = (math.pi * WHEEL_DIAMETER) / TICKS_PER_REV


class Robot2Bridge(Node):
    def __init__(self):
        super().__init__('robot2_bridge')

        # ── Parameters ──
        # /dev/mega is a udev symlink (systemd/99-gp-serial.rules) that survives
        # USB enumeration order changes; raw ttyUSB* names are fallbacks only.
        self.declare_parameter('serial_port', '/dev/mega')
        self.declare_parameter('baud_rate', 115200)
        self.declare_parameter('manual_timeout', 0.5)
        self.declare_parameter('max_linear_speed', 0.5)
        # Torque floor for skid-steer pivots (config drive.turn_pwm) —
        # four wheels scrubbing sideways need more than driving PWM.
        self.declare_parameter('turn_pwm', 255)   # max pivot torque/speed
        # Minimum PWM that actually moves the chassis (config drive.min_pwm).
        # Below ~150 the motors hum without breaking static friction —
        # the old 80..255 mapping made the console's default speed a no-op.
        self.declare_parameter('min_pwm', 150)
        # Autonomous speed ceilings (config drive.auto_*). AUTONOMOUS drives on
        # its own, so it must be GENTLE — full-speed wander overshoots the
        # ultrasonic stop and clips walls. Forward is capped well below manual
        # (255) and pivots below turn_pwm (255). The speed slider scales within
        # these. Raise only after the obstacle response is trusted.
        # Odometry-safe ceilings (mirror config/robot2.yaml drive.*). Gentle
        # so autonomous motion never wheelspins and corrupts the yaw.
        self.declare_parameter('auto_fwd_max_pwm', 175)
        self.declare_parameter('auto_turn_pwm', 235)   # faster auto pivot (was 200)
        # Keepalive: firmware stops motors after WATCHDOG_MS (1 s) of serial
        # silence, so a non-stop command must be re-sent periodically — but
        # ONLY while fresh Twists keep arriving (deadman), otherwise a dead
        # commander would leave the robot driving forever.
        self.declare_parameter('keepalive_period', 0.3)
        self.declare_parameter('deadman_timeout', 0.8)
        # Front ultrasonics (config ultrasonic.*). The firmware appends two
        # distances (cm) to the D: packet; the bridge publishes them as
        # Range and — critically — blocks any FORWARD command while either
        # reads below stop_cm. This back-stops BOTH manual and auto driving:
        # driving into a wall is never intended. Turns/reverse stay allowed
        # (the sensors only face forward). Hysteresis (clear_cm) stops it
        # flapping at the threshold.
        self.declare_parameter('us_enabled', True)
        self.declare_parameter('us_max_cm', 150)
        self.declare_parameter('us_stop_cm', 25)
        self.declare_parameter('us_clear_cm', 40)
        self.declare_parameter('us_fov_deg', 15.0)
        # PWM slew limit (config drive.ramp_pwm_per_s). Stepping straight
        # to min_pwm/turn_pwm from rest is a torque kick that spins the
        # wheels on carpet — wheelspin the encoders dutifully count as
        # motion (odometry drift). Ramping reaches full PWM in ~175 ms.
        self.declare_parameter('ramp_pwm_per_s', 300)   # gentle accel (was 600)
        # Stall-disarm: kill motors after this long of commanded-but-frozen,
        # then block the same direction for the cooldown (escape stays open).
        self.declare_parameter('stall_disarm_s', 3.0)
        self.declare_parameter('stall_cooldown_s', 2.0)

        # ── State ──
        self.arduino = None
        self.connected = False
        self.manual_mode = False
        self.manual_last_time = time.time()
        self.pwm_speed = 180            # what the firmware currently has
        self.pwm_target = 180           # what the active maneuver wants
        # Speed slider (CMD_SPEED -> /set_speed, 0..1). Authoritative top-speed
        # CAP applied to BOTH manual and autonomous in _twist_to_cmd — this is
        # the operator's real speed control. 1.0 = full range; default gentle.
        self._speed_scale = 0.6
        self.last_cmd = 'S'
        self.last_motion = 'S'          # last F/B/L/R/S actually sent
        self.last_twist_time = 0.0      # monotonic time of last accepted Twist
        self.estop = False
        self._serial_lock = threading.Lock()
        # Stall detector: motion commanded but wheels not turning (carpet
        # pivot friction, blocked chassis, weak under-voltage battery).
        # Field case 2026-06-11: pivot at PWM 215, estop clear, encoders
        # frozen — silently grinding motors. Announce it instead.
        self._stall_enc = None          # encoder snapshot at motion start
        self._stall_since = None
        self._stall_announced = False
        # Stall DISARM (anti-lockup): when the motors are commanded but the
        # encoders stay frozen, a stalled DC motor pulls near locked-rotor
        # current → the rail sags → the Pi browns out/throttles → control
        # locks up for ~30 s. Fix: kill the motors fast and BLOCK re-issuing
        # the same grinding direction for a short cooldown (a DIFFERENT
        # direction is allowed immediately, so the robot can escape). Also
        # published on /stall so the local nav can back-off + reorient.
        self._stalled_motion = None     # the direction that stalled (F/B/L/R)
        self._stall_block_until = 0.0   # monotonic; same direction blocked until
        # Receive-proof counters: CLI graph introspection is unavailable
        # in discovery-server mode (Humble), so the bridge itself logs
        # arrival of drive topics — first message and every 50th.
        self._n_manual = 0
        self._n_auto = 0
        # Serial backlog telemetry: how many stale D: packets the drain
        # dropped (see _serial_reader). Logged periodically so growing lag is
        # VISIBLE instead of silently crashing the robot into a wall.
        self._dropped_total = 0
        self._last_drop_log = 0.0
        # 50 Hz yaw integration done HERE, not in the gateway. The gateway
        # integrated from /imu messages with a wall-clock dt — but the drain
        # publishes /imu only for the latest packet, so it lost intermediate
        # gyro samples, and integrating an angular RATE with dropped samples
        # loses angle on every turn (field 2026-06-18: hand-rotate Beta
        # right-centre-left-centre and the map heading drifts ~45 deg). Here we
        # see EVERY packet before the drain drops it, and use the Mega's own
        # millis() timestamp for dt — immune to OS/serial/CPU-load jitter. The
        # absolute heading rides out in the IMU orientation (gateway forwards
        # it), so dropped telemetry frames never lose heading.
        self._heading = 0.0
        self._heading_bias = 0.0          # residual gyro bias (firmware pre-subtracts boot bias)
        self._heading_prev_ts = None      # Mega ts (ms) of last integrated packet
        self._heading_prev_enc = None
        # Gyro-dropout detection for the encoder-heading fallback: the GY-87
        # falls off the I2C bus intermittently and the firmware then streams
        # the last-good gyro reading IDENTICALLY every frame (NOT zero). Frozen
        # raw samples = dropout → integrate the wheel differential instead.
        self._gyro_prev_sig = None
        self._gyro_frozen_n = 0
        self._gyro_dead = False
        # Front ultrasonics: latest filtered ranges (cm) + forward-block
        # latch. Written by the serial reader thread, read in the command
        # callbacks — plain int reads/writes are atomic under the GIL.
        self._us_max_cm = int(self.get_parameter('us_max_cm').value)
        self.us_left_cm = self._us_max_cm
        self.us_right_cm = self._us_max_cm
        self._fwd_blocked = False
        self._us_seen = False        # True once the firmware actually sends them

        # ── Connect to Arduino ──
        self._connect_arduino()

        # ── Subscribers ──
        self.create_subscription(Twist, '/cmd_vel', self._auto_cb, 10)
        self.create_subscription(Twist, '/manual_cmd', self._manual_cb, 10)
        self.create_subscription(Float32, '/set_speed', self._speed_cb, 10)
        self.create_subscription(Bool, '/emergency_stop', self._estop_cb, 10)
        self.create_subscription(String, '/accessory_cmd', self._accessory_cb, 10)

        # ── Accessory state (pump / servo, firmware v5) ──
        self.accessory_pub = self.create_publisher(String, '/accessory_state', 10)

        # ── Publishers ──
        self.status_pub = self.create_publisher(String, '/motor_status', 10)
        self.encoder_pub = self.create_publisher(Int32MultiArray, '/encoders', 10)
        self.imu_pub = self.create_publisher(Imu, '/imu/data_raw', 10)
        self.log_pub = self.create_publisher(String, '/robot_log', 10)
        self.us_left_pub = self.create_publisher(Range, '/ultrasonic/left', 10)
        self.us_right_pub = self.create_publisher(Range, '/ultrasonic/right', 10)
        self.stall_pub = self.create_publisher(Bool, '/stall', 10)

        # ── Timers ──
        self.create_timer(0.1, self._check_manual_timeout)
        self.create_timer(self.get_parameter('keepalive_period').value, self._keepalive)
        self.create_timer(0.05, self._ramp_tick)   # PWM slew, 20 Hz
        # Note: No _poll_status timer — Robot 2 firmware streams D: packets
        # at 50 Hz automatically. Sending '?' would trigger printHelp() and
        # flood the serial buffer with junk text.

        # ── Serial Reader Thread ──
        self._reader_thread = threading.Thread(target=self._serial_reader, daemon=True)
        self._reader_thread.start()

        self.get_logger().info('Robot 2 Bridge started')
        self.get_logger().info(f'Arduino connected: {self.connected}')

    # ═══════════════════════════════════════
    # ARDUINO CONNECTION
    # ═══════════════════════════════════════
    def _connect_arduino(self):
        port = self.get_parameter('serial_port').value
        baud = self.get_parameter('baud_rate').value
        candidates = list(dict.fromkeys(
            [port, '/dev/mega', '/dev/ttyUSB0', '/dev/ttyACM0', '/dev/ttyUSB1']))

        for p in candidates:
            try:
                self.arduino = serial.Serial(p, baud, timeout=1)
                time.sleep(2)  # Arduino resets on serial open

                # Wait for the Mega to actually START STREAMING before we
                # call it connected. Opening the port DTR-resets the Arduino;
                # its setup() (incl. the marginal GY-87 IMU I2C init) can take
                # several seconds. The old code declared 'connected' the
                # instant the banner drained, so the reader's 3 s death-timer
                # started before the firmware reached its 50 Hz loop — if
                # setup() ran long the reader reconnected, which RE-RESET the
                # Mega, and it thrashed for a minute-plus before luck let
                # setup() finish inside the window ("map moves after 2 min").
                # Block here (uninterrupted, no reset) until a real telemetry
                # line (D:/B:) arrives. Banner lines are logged as they pass.
                # Still BOUNDED — never the unbounded in_waiting spin that
                # hung the constructor in the field (2026-06-11).
                boot_deadline = time.time() + 10.0
                streaming = False
                while time.time() < boot_deadline:
                    line = self.arduino.readline().decode(errors='ignore').strip()
                    if not line:
                        continue
                    if line.startswith(('D:', 'B:')):
                        streaming = True
                        break
                    self.get_logger().info(f'Arduino: {line}')
                if not streaming:
                    self.get_logger().warn(
                        f'{p}: opened but no telemetry in 10 s — retrying')
                    try:
                        self.arduino.close()
                    except Exception:
                        pass
                    continue

                self.connected = True
                self.get_logger().info(
                    f'Connected to Arduino on {p} @ {baud} (streaming)')
                self._send('P{}'.format(self.pwm_speed))
                return
            except Exception as e:
                self.get_logger().warn(f'Failed {p}: {e}')

        self.get_logger().error('Could not connect to Arduino on any port')

    # ═══════════════════════════════════════
    # SERIAL COMMUNICATION
    # ═══════════════════════════════════════
    def _send(self, cmd: str):
        """Send a command to the Arduino (thread-safe)."""
        if not (self.arduino and self.arduino.is_open):
            return False
        try:
            with self._serial_lock:
                self.arduino.write(f'{cmd}\n'.encode())
            self.last_cmd = cmd
            if cmd in ('F', 'B', 'L', 'R', 'S'):
                self.last_motion = cmd
            return True
        except Exception as e:
            self.get_logger().error(f'Serial write error: {e}')
            self.connected = False
            return False

    def _keepalive(self):
        """Re-send the active motion command while the commander is alive.

        Layered safety:
          1. fresh Twists arriving  → re-send last motion (feeds firmware watchdog)
          2. commander went silent  → send explicit 'S' once (deadman stop)
          3. this process dies      → firmware watchdog stops motors in 1 s
        """
        if self.estop or self.last_motion == 'S':
            return
        deadman = self.get_parameter('deadman_timeout').value
        if time.monotonic() - self.last_twist_time <= deadman:
            # An obstacle can appear while a forward command is HELD (the
            # robot creeps into it) — re-check before every keepalive resend.
            if self.last_motion == 'F' and not self._forward_clear():
                self._send('S')
                return
            self._send(self.last_motion)
        else:
            self.get_logger().warn('Deadman: commander silent — stopping')
            self._send('S')

    def _poll_status(self):
        """Periodically send '?' to request STS: data (old firmware compatibility)."""
        self._send('?')

    def _serial_reader(self):
        """Background thread: reads, parses, and — critically — RECOVERS.

        Field root-cause 2026-06-12: robot2's Mega USB link drops and
        re-enumerates minutes into a session (/dev/ttyUSB0 recreated).
        The old loop swallowed the resulting exceptions and spun on the
        stale handle forever: encoders/IMU/STS froze, drive characters
        went into a dead tty, and the robot 'stopped responding' with
        every process looking healthy. Masqueraded for two days as DDS
        transport failures (a service restart reopened the port, which
        looked like curing SHM/discovery).

        Recovery: any exception OR 5 s of silence (firmware streams at
        50 Hz — silence IS death) → close, announce on /robot_log, and
        reconnect in a loop until the Mega is back.

        DRAIN-TO-LATEST (root-cause fix 2026-06-17, "fine for a minute then
        crashes into walls"): the old loop processed EVERY line FIFO — 5 ROS
        publishes + 3 clock reads per D: packet at 50 Hz on a Pi 3B+. When the
        consumer can't quite hold 50 Hz, the kernel serial buffer fills and
        every readline() returns progressively OLDER data: fine while the
        buffer absorbs the slack (~1 min), then every sensor reading is seconds
        stale. The ultrasonic guard then sees a wall that's already been hit,
        and the laptop odom integrates a stale gyro → corrupted heading.
        Fix: each pass, consume ALL bytes the OS has buffered and act only on
        the NEWEST D: packet (encoders are cumulative, so dropping intermediate
        packets loses zero odometry; the latest ultrasonic range is exactly
        what the obstacle guard needs). Latency is now bounded to one drain
        cycle no matter how loaded the Pi gets. ACK/STS lines keep their order.
        """
        last_line_t = time.monotonic()
        buf = b''
        while rclpy.ok():
            if not (self.arduino and self.arduino.is_open):
                self._announce_serial('SERIAL: reconnecting to Mega…')
                self._connect_arduino()
                if self.connected:
                    self._announce_serial('SERIAL: Mega link restored')
                    last_line_t = time.monotonic()
                    buf = b''
                else:
                    time.sleep(2.0)
                continue
            try:
                # Block for at least one byte (timeout=1 s), then sweep up
                # everything else already waiting — this is the drain.
                chunk = self.arduino.read(max(1, self.arduino.in_waiting))
            except Exception as exc:
                self.get_logger().error(f'serial lost ({exc}) — reconnecting')
                self._announce_serial('SERIAL: Mega link LOST — reconnecting')
                self._drop_serial()
                buf = b''
                continue
            if not chunk:
                # 5 s, not 3: the firmware streams at 50 Hz so true death is
                # still caught fast, but a brief stall under motor load no
                # longer triggers a reconnect — and a reconnect DTR-resets the
                # Mega, the very thing that caused the startup thrash.
                if time.monotonic() - last_line_t > 5.0:
                    self.get_logger().error(
                        'serial silent 5 s — USB re-enumerated? reconnecting')
                    self._announce_serial(
                        'SERIAL: Mega silent 5 s — reconnecting')
                    self._drop_serial()
                    buf = b''
                continue
            last_line_t = time.monotonic()

            buf += chunk
            lines = buf.split(b'\n')
            buf = lines.pop()                 # keep the trailing partial line

            latest_d = None
            dropped = 0
            for raw in lines:
                try:
                    line = raw.decode(errors='ignore').strip()
                except Exception:
                    continue
                if not line:
                    continue
                if line.startswith('D:'):
                    # Integrate yaw from EVERY packet (cheap scalar math) so no
                    # gyro sample is lost to the drain — see _integrate_heading.
                    parts = line[2:].split(',')
                    if len(parts) >= 11:
                        self._integrate_heading(parts)
                    if latest_d is not None:
                        dropped += 1          # an older D: we will skip (publish)
                    latest_d = line
                elif line.startswith('STS:'):
                    self._parse_sts_data(line)
                elif line.startswith(('OK:', 'ERR:')):
                    # v5 firmware command ACKs (pump/servo/e-stop) → dashboard
                    self.accessory_pub.publish(String(data=line))
                    if line.startswith('ERR:'):
                        self.get_logger().warn(f'Arduino: {line}')

            if latest_d is not None:
                self._parse_sensor_data(latest_d)
            if dropped:
                self._dropped_total += dropped
                now = time.monotonic()
                if now - self._last_drop_log > 5.0:
                    self._last_drop_log = now
                    line = (f'SERIAL BACKLOG: skipped {self._dropped_total} '
                            'stale packets (drain keeping readings fresh) — '
                            'Pi under load; readings stay current')
                    self.get_logger().warn(line)
                    self._announce_serial(line)

    def _drop_serial(self):
        try:
            if self.arduino:
                self.arduino.close()
        except Exception:
            pass
        self.arduino = None
        self.connected = False
        time.sleep(1.0)          # let udev settle after a re-enumeration

    def _announce_serial(self, line: str):
        try:
            self.log_pub.publish(String(data=line))
        except Exception:
            pass

    def _parse_sts_data(self, line: str):
        """Parse old firmware format: STS:speed,estop,enc1,enc2,enc3,enc4"""
        try:
            # Publish raw status string for dashboard
            status_msg = String()
            status_msg.data = line
            self.status_pub.publish(status_msg)

            # Also publish encoder values as Int32MultiArray
            parts = line[4:].split(',')
            if len(parts) >= 6:
                encs = [int(parts[2]), int(parts[3]), int(parts[4]), int(parts[5])]
                enc_msg = Int32MultiArray()
                enc_msg.data = encs
                self.encoder_pub.publish(enc_msg)
        except (ValueError, IndexError) as e:
            self.get_logger().debug(f'STS parse error: {e}')

    def _integrate_heading(self, parts):
        """Integrate yaw from ONE D: packet using the Mega's ms timestamp.

        `parts` is the already-split D: body (parts[0]=ts ms, 1..4=enc,
        10=gz raw). Called for every drained packet so the 50 Hz gyro stream
        is integrated in full, with a hardware-timestamp dt that no software
        jitter can corrupt. Bias is re-learned only while the wheels are
        still (manual pushes count as 'moving' via the chassis, but the
        encoders don't turn — so a hand-rotation is correctly NOT learned as
        bias; it just integrates)."""
        try:
            ts = int(parts[0])
            enc = [int(parts[i]) for i in range(1, 5)]
            gx_raw, gy_raw, gz_raw = int(parts[8]), int(parts[9]), int(parts[10])
        except (ValueError, IndexError):
            return
        gz = gz_raw * GYRO_SCALE * GYRO_SCALE_CORRECTION   # raw -> rad/s, scale-cal

        # ── GY-87 dropout detection → ENCODER-HEADING FALLBACK ──
        # A live MPU jitters every sample; the GY-87 falling off I2C makes the
        # firmware stream the last reading IDENTICALLY (or all-zero if unwired).
        # Either way the gyro is useless, so integrate the wheel differential
        # instead — driven turns still update heading. Auto-restores on recover.
        sig = (gx_raw, gy_raw, gz_raw)
        self._gyro_frozen_n = (self._gyro_frozen_n + 1) if sig == self._gyro_prev_sig else 0
        self._gyro_prev_sig = sig
        dead = (self._gyro_frozen_n >= 25
                or (gx_raw == 0 and gy_raw == 0 and gz_raw == 0))
        if dead != self._gyro_dead:
            self._gyro_dead = dead
            msg = ('GYRO DROPOUT — heading from ENCODERS (driven turns) until '
                   'it recovers' if dead else
                   'GYRO recovered — heading back on the gyro')
            self.get_logger().warn(msg)
            try:
                self.log_pub.publish(String(data=msg))
            except Exception:
                pass

        # encoder differential (same convention as the laptop odom)
        d_theta_enc = 0.0
        if self._heading_prev_enc is not None:
            pe = self._heading_prev_enc
            d_left = ((enc[0] - pe[0]) + (enc[1] - pe[1])) / 2.0
            d_right = ((enc[2] - pe[2]) + (enc[3] - pe[3])) / 2.0
            d_theta_enc = (d_right - d_left) * METERS_PER_TICK / WHEEL_BASE
        wheels_moving = (self._heading_prev_enc is not None and
                         any(e != p for e, p in zip(enc, self._heading_prev_enc)))
        self._heading_prev_enc = enc

        # Learn residual bias only when idle AND the gyro is alive — never
        # during a hand-rotation (gyro spins, wheels still) or a dropout.
        if not dead and not wheels_moving and abs(gz - self._heading_bias) < 0.05:
            self._heading_bias += 0.01 * (gz - self._heading_bias)

        if self._heading_prev_ts is not None:
            dt = (ts - self._heading_prev_ts) / 1000.0
            if 0.0 < dt < 0.1:                        # ignore Mega resets / gaps
                d_theta = d_theta_enc if dead else (gz - self._heading_bias) * dt
                self._heading = math.atan2(math.sin(self._heading + d_theta),
                                           math.cos(self._heading + d_theta))
        self._heading_prev_ts = ts

    def _parse_sensor_data(self, line: str):
        """Parse: D:timestamp,e1,e2,e3,e4,ax,ay,az,gx,gy,gz"""
        try:
            parts = line[2:].split(',')
            if len(parts) < 11:
                return

            ts   = int(parts[0])
            encs = [int(parts[i]) for i in range(1, 5)]
            self._check_stall(encs)
            ax, ay, az = int(parts[5]), int(parts[6]), int(parts[7])
            gx, gy, gz = int(parts[8]), int(parts[9]), int(parts[10])

            # Fields 17,18 = front ultrasonics (cm) — only present on the
            # 2026-06-13+ firmware. Older firmware (or none flashed yet)
            # simply lacks them, so the guard stays disarmed and reads clear.
            if len(parts) >= 19:
                self._update_ultrasonics(int(parts[17]), int(parts[18]))

            # ── Publish Encoders ──
            enc_msg = Int32MultiArray()
            enc_msg.data = encs
            self.encoder_pub.publish(enc_msg)

            # ── Publish IMU ──
            imu_msg = Imu()
            imu_msg.header.stamp = self.get_clock().now().to_msg()
            imu_msg.header.frame_id = 'imu_link'

            # Convert raw → physical units
            imu_msg.linear_acceleration.x = ax * ACCEL_SCALE
            imu_msg.linear_acceleration.y = ay * ACCEL_SCALE
            imu_msg.linear_acceleration.z = az * ACCEL_SCALE

            imu_msg.angular_velocity.x = gx * GYRO_SCALE
            imu_msg.angular_velocity.y = gy * GYRO_SCALE
            imu_msg.angular_velocity.z = gz * GYRO_SCALE

            # Orientation: yaw from the bridge's 50 Hz, hardware-timestamped
            # integration (see _integrate_heading). Marked VALID (cov[0] >= 0)
            # so the gateway forwards this absolute heading instead of doing
            # its own jittery wall-clock integration off thinned /imu samples.
            h = self._heading
            imu_msg.orientation.x = 0.0
            imu_msg.orientation.y = 0.0
            imu_msg.orientation.z = math.sin(h / 2.0)
            imu_msg.orientation.w = math.cos(h / 2.0)
            imu_msg.orientation_covariance[0] = 0.01

            self.imu_pub.publish(imu_msg)

            # ── Publish Status (for dashboard compatibility) ──
            status_msg = String()
            status_msg.data = f'STS:{self.pwm_speed},0,{encs[0]},{encs[1]},{encs[2]},{encs[3]}'
            self.status_pub.publish(status_msg)

        except (ValueError, IndexError) as e:
            self.get_logger().debug(f'Parse error: {e}')

    # ═══════════════════════════════════════
    # MOVEMENT COMMANDS
    # ═══════════════════════════════════════
    def _check_stall(self, encs):
        """Motion commanded but encoders frozen → DISARM the motors fast.

        A stalled motor pulls locked-rotor current; leaving it grinding sags
        the rail and browns out the Pi (the ~30 s lock-up). So when the wheels
        stay frozen under a drive command past stall_disarm_s, stop the motors
        and latch a cooldown that blocks the SAME direction (escape — a
        different direction — is still allowed). Re-arms after each cooldown,
        so a robot driven into a wall stalls→stops→releases repeatedly in
        short bursts instead of one long current-pinned lock-up."""
        if self.last_motion == 'S' or self.estop:
            self._stall_enc = None
            self._stall_announced = False
            self._reset_stall()
            return
        now = time.monotonic()
        if self._stall_enc is None:
            self._stall_enc = list(encs)
            self._stall_since = now
            return
        moved = sum(abs(e - p) for e, p in zip(encs, self._stall_enc))
        if moved >= 5:                       # wheels turning → healthy
            self._stall_enc = list(encs)
            self._stall_since = now
            self._stall_announced = False
            self._reset_stall()
            return
        disarm_s = float(self.get_parameter('stall_disarm_s').value)
        if now - self._stall_since > disarm_s and now >= self._stall_block_until:
            self._stalled_motion = self.last_motion
            cooldown = float(self.get_parameter('stall_cooldown_s').value)
            self._stall_block_until = now + cooldown
            self._send('S')                  # kill the current draw NOW
            try:
                self.stall_pub.publish(Bool(data=True))
            except Exception:
                pass
            line = (f'MOTOR STALL: cmd={self.last_motion} PWM={self.pwm_speed} '
                    f'frozen >{disarm_s:.1f}s — motors DISARMED '
                    f'(same dir blocked {cooldown:.0f}s; reverse/turn to escape)')
            self.get_logger().warn(line)
            self.log_pub.publish(String(data=line))

    def _reset_stall(self):
        if self._stalled_motion is not None:
            self._stalled_motion = None
            try:
                self.stall_pub.publish(Bool(data=False))
            except Exception:
                pass
        self._stall_block_until = 0.0

    def _stall_filter(self, cmd: str) -> str:
        """Block the stalled direction during its cooldown; a different
        direction clears the stall so the robot can immediately escape."""
        if self._stalled_motion is None:
            return cmd
        if cmd != self._stalled_motion:
            self._reset_stall()              # escaping in a new direction
            return cmd
        if time.monotonic() < self._stall_block_until:
            return 'S'                       # still cooling down → hold
        return cmd                           # cooldown over → allow a retry

    def _update_ultrasonics(self, left_cm: int, right_cm: int):
        """Store + publish the two front ranges; runs in the reader thread."""
        self.us_left_cm = left_cm
        self.us_right_cm = right_cm
        self._us_seen = True
        fov = float(self.get_parameter('us_fov_deg').value)
        max_m = self._us_max_cm / 100.0
        for cm, pub, frame in ((left_cm, self.us_left_pub, 'ultrasonic_left'),
                               (right_cm, self.us_right_pub, 'ultrasonic_right')):
            m = Range()
            m.header.stamp = self.get_clock().now().to_msg()
            m.header.frame_id = frame
            m.radiation_type = Range.ULTRASOUND
            m.field_of_view = math.radians(fov)
            m.min_range = 0.02
            m.max_range = max_m
            m.range = cm / 100.0
            pub.publish(m)

    def _forward_clear(self) -> bool:
        """Hysteretic gate: is it safe to drive FORWARD right now?

        Blocks below stop_cm, re-allows only above clear_cm — so a robot
        creeping up to the threshold doesn't stutter F/S/F. Disarmed unless
        the firmware is actually reporting ranges (so this can't strand a
        robot whose Mega predates the ultrasonic build)."""
        if not (self.get_parameter('us_enabled').value and self._us_seen):
            return True
        nearest = min(self.us_left_cm, self.us_right_cm)
        stop_cm = int(self.get_parameter('us_stop_cm').value)
        clear_cm = int(self.get_parameter('us_clear_cm').value)
        if self._fwd_blocked:
            if nearest >= clear_cm:
                self._fwd_blocked = False
                self.log_pub.publish(String(
                    data=f'OBSTACLE CLEARED: front {nearest}cm — forward re-enabled'))
        else:
            if nearest < stop_cm:
                self._fwd_blocked = True
                line = (f'OBSTACLE: front {nearest}cm < {stop_cm}cm — '
                        'forward BLOCKED (turn or reverse to escape)')
                self.get_logger().warn(line)
                self.log_pub.publish(String(data=line))
        return not self._fwd_blocked

    def _twist_to_cmd(self, msg: Twist, is_auto: bool = False) -> str:
        linear = msg.linear.x
        angular = msg.angular.z

        if abs(linear) < 0.05 and abs(angular) < 0.1:
            return 'S'

        # Drive-biased arbitration: while a forward command is active, a
        # steering correction must DOMINATE (2x) before we drop to a pivot.
        # The old `linear > angular` test flapped F→L→F mid-drive whenever
        # the goto controller steered — that was the visible jerk.
        if abs(linear) >= 0.05 and abs(angular) <= 2.0 * abs(linear):
            cmd = 'F' if linear > 0 else 'B'
        else:
            cmd = 'L' if angular > 0 else 'R'

        # PWM by maneuver. The speed slider (self._speed_scale, 0..1) is the
        # authoritative top-speed CAP and applies to BOTH manual and auto —
        # this is what was missing (the slider used to be overwritten here, and
        # autonomous was never capped, so it ran flat-out and clipped walls).
        # Autonomous uses gentler ceilings than manual.
        max_lin = self.get_parameter('max_linear_speed').value
        min_pwm = int(self.get_parameter('min_pwm').value)
        scale = self._speed_scale
        if cmd in ('F', 'B'):
            top = int(self.get_parameter('auto_fwd_max_pwm').value) if is_auto else 255
            cap = min_pwm + scale * (top - min_pwm)
            factor = min(abs(linear) / max_lin, 1.0) if max_lin > 0 else 1.0
            new_pwm = int(min_pwm + factor * (cap - min_pwm))
        elif is_auto:
            # gentle, slider-scaled pivot (floored so it never stall-judders)
            turn_cap = int(self.get_parameter('auto_turn_pwm').value)
            new_pwm = int(min_pwm + scale * (turn_cap - min_pwm))
        else:
            new_pwm = int(self.get_parameter('turn_pwm').value)

        # PWM is no longer stepped to directly — _ramp_tick slews toward
        # the target. Soft launch: from rest, torque starts at the
        # static-friction floor and climbs, instead of kicking straight
        # to min_pwm/turn_pwm and spinning the wheels on carpet.
        self.pwm_target = new_pwm
        if cmd != 'S' and self.last_motion == 'S' and self.pwm_speed != min_pwm:
            self.pwm_speed = min_pwm
            self._send(f'P{min_pwm}')
        return cmd

    def _ramp_tick(self):
        """Slew the firmware PWM toward the maneuver target — UP only.

        Downward changes (slowing, stopping) apply immediately: reducing
        torque never breaks traction, and braking must never lag. The
        firmware applies a new P to the motion already in progress, so
        this works mid-drive without re-sending the direction letter.
        """
        if self.estop or self.last_motion == 'S':
            return
        target, cur = self.pwm_target, self.pwm_speed
        if abs(target - cur) < 5:                   # don't spam serial
            return
        if target < cur:
            new = target
        else:
            rate = int(self.get_parameter('ramp_pwm_per_s').value)
            new = min(target, cur + max(5, int(rate * 0.05)))
        self.pwm_speed = new
        self._send(f'P{new}')

    def _manual_cb(self, msg: Twist):
        self._n_manual += 1
        if self._n_manual == 1 or self._n_manual % 50 == 0:
            self.get_logger().info(
                f'/manual_cmd #{self._n_manual} vx={msg.linear.x:+.2f} '
                f'wz={msg.angular.z:+.2f} estop={self.estop}')
        if self.estop:
            return
        self.manual_mode = True
        self.manual_last_time = time.time()
        self.last_twist_time = time.monotonic()
        cmd = self._twist_to_cmd(msg)
        if cmd == 'F' and not self._forward_clear():
            cmd = 'S'
        cmd = self._stall_filter(cmd)        # anti-lockup: hold a grinding dir
        if cmd != self.last_motion or cmd == 'S':
            self._send(cmd)

    def _auto_cb(self, msg: Twist):
        self._n_auto += 1
        if self._n_auto == 1 or self._n_auto % 50 == 0:
            self.get_logger().info(
                f'/cmd_vel #{self._n_auto} vx={msg.linear.x:+.2f} '
                f'wz={msg.angular.z:+.2f} estop={self.estop} '
                f'manual={self.manual_mode}')
        if self.estop or self.manual_mode:
            return
        self.last_twist_time = time.monotonic()
        cmd = self._twist_to_cmd(msg, is_auto=True)
        if cmd == 'F' and not self._forward_clear():
            cmd = 'S'
        cmd = self._stall_filter(cmd)        # anti-lockup: hold a grinding dir
        if cmd != self.last_motion or cmd == 'S':
            self._send(cmd)

    def _speed_cb(self, msg: Float32):
        # The slider is the top-speed CAP, applied per-command in
        # _twist_to_cmd (manual + auto). Don't poke pwm_target here — that's
        # what made the slider a no-op (the next drive command overwrote it).
        self._speed_scale = max(0.0, min(1.0, float(msg.data)))
        self.get_logger().info(f'speed scale -> {self._speed_scale:.2f}')

    def _estop_cb(self, msg: Bool):
        """Emergency stop — highest priority, latches until released."""
        if msg.data:
            self.estop = True
            self._send('S')           # works on v4 firmware
            self._send('E')           # hard-brake + latch on v5 firmware (ignored by v4)
            self.get_logger().warn('EMERGENCY STOP ENGAGED')
        else:
            self.estop = False
            self._send('X')           # release latch on v5 firmware (ignored by v4)
            self.get_logger().info('Emergency stop released')

    def _accessory_cb(self, msg: String):
        """Forward arm-servo ('A<deg>') and buzzer ('N<n>') commands. The pump
        was relocated to Alpha (robot1) on 2026-06-23, so 'U' is no longer sent
        here; reject it defensively."""
        cmd = msg.data.strip()
        if not cmd:
            return
        if cmd[0] == 'N':                 # buzzer beep — non-actuating, OK on e-stop
            self._send(cmd)
            return
        if self.estop:
            self.get_logger().warn(f'Accessory cmd {cmd!r} blocked by e-stop')
            return
        if cmd[0] != 'A':
            self.get_logger().warn(f'Unknown accessory cmd: {cmd!r}')
            return
        self._send(cmd)

    def _check_manual_timeout(self):
        if self.manual_mode:
            timeout = self.get_parameter('manual_timeout').value
            if time.time() - self.manual_last_time > timeout:
                self.manual_mode = False

    # ═══════════════════════════════════════
    # SHUTDOWN
    # ═══════════════════════════════════════
    def destroy_node(self):
        if self.arduino:
            self._send('S')
            time.sleep(0.1)
            self.arduino.close()
        super().destroy_node()


def main(args=None):
    rclpy.init(args=args)
    node = Robot2Bridge()
    try:
        rclpy.spin(node)
    except KeyboardInterrupt:
        pass
    finally:
        node.destroy_node()
        rclpy.shutdown()


if __name__ == '__main__':
    main()
