GP-Golden-9/GP/dashboard_qt/ui/ops_panel.py

"""Operations panel — teleop for the ACTIVE robot, organized top-down the
way an operator reaches for it:

    drive mode → joystick (proportional) → speed presets → intervention
    tools → E-STOP (always at the bottom, always reachable)

The joystick emits the protocol's 10 Hz drive stream while engaged; the
keyboard path (WASD in the main window) feeds the same stream.
"""

from __future__ import annotations

from PySide6.QtCore import Qt, Signal
from PySide6.QtWidgets import (QGridLayout, QGroupBox, QHBoxLayout, QLabel,
                               QProgressBar, QPushButton, QSlider, QVBoxLayout,
                               QWidget)

from ui import theme
from ui.joystick import Joystick


class OpsPanel(QWidget):
    driveRequested = Signal(float, float)      # vx (m/s), wz (rad/s)
    stopRequested = Signal()
    estopToggled = Signal(bool)
    modeChanged = Signal(str)                  # 'manual' | 'auto'
    speedChanged = Signal(float)               # m/s
    pumpRequested = Signal(bool)
    servoRequested = Signal(int)

    def __init__(self, prefs, parent=None):
        super().__init__(parent)
        self.prefs = prefs
        self._speed = prefs.speed_default
        self._estop = False
        # Keep the teleop column from being squeezed to a sliver when the map
        # claims the free width — the joystick, tools and proximity readout
        # must stay fully visible.
        self.setMinimumWidth(312)

        root = QVBoxLayout(self)
        root.setContentsMargins(10, 8, 10, 10)
        root.setSpacing(9)

        # ── target + state line ──
        head = QHBoxLayout()
        self.target_lbl = QLabel('—')
        self.target_lbl.setStyleSheet('font-size:13px; font-weight:800; '
                                      'letter-spacing:1px;')
        head.addWidget(self.target_lbl)
        head.addStretch(1)
        self.state_lbl = QLabel('READY')
        self.state_lbl.setStyleSheet(f'color:{theme.GOOD}; font-weight:800; '
                                     'font-size:11px; letter-spacing:2px;')
        head.addWidget(self.state_lbl)
        root.addLayout(head)

        # ── drive mode ──
        mode_row = QHBoxLayout()
        mode_row.setSpacing(6)
        self.btn_manual = QPushButton('MANUAL')
        self.btn_auto = QPushButton('AUTONOMOUS')
        for b in (self.btn_manual, self.btn_auto):
            b.setCheckable(True)
            b.setFocusPolicy(Qt.NoFocus)
            b.setMinimumHeight(32)
            mode_row.addWidget(b)
        self.btn_manual.setChecked(True)
        self.btn_manual.clicked.connect(lambda: self._set_mode('manual'))
        self.btn_auto.clicked.connect(lambda: self._set_mode('auto'))
        root.addLayout(mode_row)

        # ── joystick ──
        joy_box = QGroupBox('TELEOP · DRAG = PROPORTIONAL · WASD / ARROWS')
        jl = QVBoxLayout(joy_box)
        self.joystick = Joystick()
        jl.addWidget(self.joystick, alignment=Qt.AlignHCenter)
        self.joystick.vector.connect(self._joy_vector)
        root.addWidget(joy_box)

        # ── speed ──
        speed_box = QGroupBox('SPEED LIMIT')
        sl = QVBoxLayout(speed_box)
        row = QHBoxLayout()
        self.speed_slider = QSlider(Qt.Horizontal)
        self.speed_slider.setFocusPolicy(Qt.NoFocus)
        self.speed_slider.setRange(int(prefs.speed_min * 100),
                                   int(prefs.speed_max * 100))
        self.speed_slider.setValue(int(prefs.speed_default * 100))
        self.speed_slider.valueChanged.connect(self._speed_moved)
        self.speed_lbl = QLabel(f'{prefs.speed_default:.2f} m/s')
        self.speed_lbl.setStyleSheet(f'color:{theme.ACCENT}; '
                                     f'font-family:{theme.MONO}; font-weight:700;')
        self.speed_lbl.setMinimumWidth(70)
        self.speed_lbl.setAlignment(Qt.AlignRight | Qt.AlignVCenter)
        row.addWidget(self.speed_slider, 1)
        row.addWidget(self.speed_lbl)
        sl.addLayout(row)
        presets = QHBoxLayout()
        presets.setSpacing(5)
        for pct in (25, 50, 75, 100):
            b = QPushButton(f'{pct}%')
            b.setFocusPolicy(Qt.NoFocus)
            b.setStyleSheet('font-size:10px; padding:3px 0;')
            b.clicked.connect(lambda _=False, p=pct: self._preset(p))
            presets.addWidget(b)
        sl.addLayout(presets)
        root.addWidget(speed_box)

        # ── intervention tools (robot2) ──
        self.tools_box = QGroupBox('INTERVENTION TOOLS')
        tl = QGridLayout(self.tools_box)
        tl.setSpacing(7)
        self.pump_btn = QPushButton('PUMP — HOLD TO SPRAY · MAX 10 s')
        self.pump_btn.setFocusPolicy(Qt.NoFocus)
        self.pump_btn.setMinimumHeight(40)
        self.pump_btn.setStyleSheet(
            f'background:#0c3349; border:1px solid #155e85; color:#7dd3fc; '
            'font-weight:700; border-radius:8px;')
        self.pump_btn.pressed.connect(lambda: self._pump(True))
        self.pump_btn.released.connect(lambda: self._pump(False))
        tl.addWidget(self.pump_btn, 0, 0, 1, 3)
        self.servo_cap = QLabel('ARM')
        self.servo_cap.setStyleSheet(f'color:{theme.MUTED}; font-size:9px; font-weight:700;')
        tl.addWidget(self.servo_cap, 1, 0)
        self.servo_slider = QSlider(Qt.Horizontal)
        self.servo_slider.setFocusPolicy(Qt.NoFocus)
        self.servo_slider.setRange(10, 170)
        self.servo_slider.setValue(90)
        self.servo_slider.sliderReleased.connect(
            lambda: self.servoRequested.emit(self.servo_slider.value()))
        self.servo_lbl = QLabel('90°')
        self.servo_lbl.setStyleSheet(f'color:{theme.ACCENT}; '
                                     f'font-family:{theme.MONO}; font-weight:700;')
        self.servo_slider.valueChanged.connect(
            lambda v: self.servo_lbl.setText(f'{v}°'))
        tl.addWidget(self.servo_slider, 1, 1)
        tl.addWidget(self.servo_lbl, 1, 2)
        root.addWidget(self.tools_box)

        # ── gas level (robot3 inspector) ──
        self.gas_box = QGroupBox('GAS LEVEL · INSPECTOR')
        gv = QVBoxLayout(self.gas_box)
        self.gas_bar = QProgressBar()
        self.gas_bar.setRange(0, 4095)          # ESP32 raw ADC range
        self.gas_bar.setTextVisible(False)
        self.gas_bar.setMinimumHeight(24)
        gv.addWidget(self.gas_bar)
        self.gas_val_lbl = QLabel('—')
        self.gas_val_lbl.setStyleSheet(f'font-family:{theme.MONO}; '
                                       'font-weight:700; font-size:13px;')
        self.gas_val_lbl.setAlignment(Qt.AlignCenter)
        gv.addWidget(self.gas_val_lbl)
        root.addWidget(self.gas_box)
        self.gas_box.setVisible(False)

        # ── front ultrasonics (robot2 intervener) ──
        self.prox_box = QGroupBox('PROXIMITY · FRONT ULTRASONIC')
        pv = QGridLayout(self.prox_box)
        pv.setVerticalSpacing(5)
        pv.setHorizontalSpacing(8)
        self.prox_bars: dict = {}
        self.prox_lbls: dict = {}
        for row, (key, name) in enumerate((('l', 'LEFT'), ('r', 'RIGHT'))):
            cap = QLabel(name)
            cap.setStyleSheet(f'color:{theme.MUTED}; font-size:9px; '
                              'font-weight:700; letter-spacing:1px;')
            bar = QProgressBar()
            bar.setRange(0, 150)                 # cm; firmware echo cap
            bar.setTextVisible(False)
            bar.setMinimumHeight(16)
            val = QLabel('—')
            val.setStyleSheet(f'font-family:{theme.MONO}; font-weight:700; '
                              'font-size:12px;')
            val.setAlignment(Qt.AlignRight | Qt.AlignVCenter)
            pv.addWidget(cap, row, 0)
            pv.addWidget(bar, row, 1)
            pv.addWidget(val, row, 2)
            self.prox_bars[key] = bar
            self.prox_lbls[key] = val
        self._prox_band: dict = {'l': None, 'r': None}   # restyle only on change
        self._prox_maxcount: dict = {'l': 0, 'r': 0}     # frames pinned at cap
        self._prox_dead: dict = {'l': False, 'r': False}
        root.addWidget(self.prox_box)
        self.prox_box.setVisible(False)

        root.addStretch(1)

        # ── E-STOP ──
        self.estop_btn = QPushButton('EMERGENCY STOP · Esc')
        self.estop_btn.setFocusPolicy(Qt.NoFocus)
        self.estop_btn.setMinimumHeight(46)
        self.estop_btn.setStyleSheet(theme.ESTOP_IDLE)
        self.estop_btn.clicked.connect(lambda: self.set_estop(not self._estop))
        root.addWidget(self.estop_btn)

    # ── public API ────────────────────────────────────────────────────────
    def set_target(self, name: str, robot_id: str, has_pump: bool = False,
                   has_servo: bool = False, has_gas: bool = False,
                   has_ultra: bool = False) -> None:
        self.target_lbl.setText(f'{name} · {robot_id}')
        # Pump lives on Alpha (robot1), the arm servo on Beta (robot2) — show
        # each tool only for the robot that has it.
        self.pump_btn.setVisible(has_pump)
        self.servo_cap.setVisible(has_servo)
        self.servo_slider.setVisible(has_servo)
        self.servo_lbl.setVisible(has_servo)
        self.tools_box.setVisible(has_pump or has_servo)
        self.gas_box.setVisible(has_gas)
        self.prox_box.setVisible(has_ultra)

    def set_ultrasonic(self, us: dict | None, stop_cm: float = 25,
                       slow_cm: float = 60) -> None:
        """Live front-left/right distance bars: red under the hard-stop
        threshold, amber in the slow-down zone, green clear.

        Called at the telemetry rate (~20 Hz). setValue/setText are cheap, but
        setStyleSheet forces a full style re-polish — doing it every frame
        backed up the UI thread and lagged the map. So restyle ONLY when the
        colour band actually changes (rare)."""
        for key in ('l', 'r'):
            bar = self.prox_bars[key]
            lbl = self.prox_lbls[key]
            m = us.get(key) if us else None
            cm = None if m is None else m * 100.0
            # A working sensor's reading jitters; one PINNED at the echo cap
            # (~150 cm) for seconds isn't "clear" — it's getting no echo (dead/
            # disconnected). Flag that instead of a misleading full green bar.
            at_cap = cm is not None and cm >= 148.0
            self._prox_maxcount[key] = (self._prox_maxcount[key] + 1) if at_cap else 0
            dead = self._prox_maxcount[key] > 60        # ~3 s frozen at the cap
            if cm is None or dead:
                band, color = 'none', theme.BAD if dead else theme.MUTED
            elif cm <= stop_cm:
                band, color = 'stop', theme.BAD
            elif cm <= slow_cm:
                band, color = 'slow', theme.WARN
            else:
                band, color = 'clear', theme.GOOD

            if band != self._prox_band[key] or (dead != self._prox_dead[key]):
                self._prox_band[key] = band
                self._prox_dead[key] = dead
                bar.setStyleSheet('' if band == 'none' else (
                    f'QProgressBar{{border:1px solid {theme.BORDER};'
                    f'border-radius:4px;background:#111;}} '
                    f'QProgressBar::chunk{{background:{color};border-radius:3px;}}'))
                lbl.setStyleSheet(f'color:{color}; font-family:{theme.MONO}; '
                                  f'font-size:12px;'
                                  + ('' if band == 'none' and not dead else
                                     ' font-weight:700;'))

            # cheap per-frame updates
            bar.setValue(0 if (cm is None or dead) else max(0, min(int(cm), 150)))
            lbl.setText('NO ECHO - check sensor' if dead else
                        ('- no echo' if cm is None else f'{cm:.0f} cm'))

    def set_gas(self, value: int, alarm: bool, warn_at: int = 2000,
                alarm_at: int = 3000) -> None:
        """Update the gas gauge: green normal, amber elevated, red alarm."""
        self.gas_bar.setValue(max(0, min(int(value), 4095)))
        if alarm or value >= alarm_at:
            color, status = theme.BAD, 'ALARM'
        elif value >= warn_at:
            color, status = theme.WARN, 'elevated'
        else:
            color, status = theme.GOOD, 'normal'
        self.gas_bar.setStyleSheet(
            f'QProgressBar{{border:1px solid {theme.BORDER};border-radius:4px;'
            f'background:#111;}} '
            f'QProgressBar::chunk{{background:{color};border-radius:3px;}}')
        self.gas_val_lbl.setText(f'{value}  ·  {status}')
        self.gas_val_lbl.setStyleSheet(
            f'color:{color}; font-family:{theme.MONO}; '
            'font-weight:700; font-size:13px;')

    def set_estop(self, engage: bool) -> None:
        if engage == self._estop:
            return
        self._estop = engage
        self.joystick.set_enabled_logic(not engage)
        if engage:
            self.state_lbl.setText('⛔ E-STOP')
            self.state_lbl.setStyleSheet(f'color:{theme.BAD}; font-weight:800;'
                                         'font-size:11px; letter-spacing:2px;')
            self.estop_btn.setText('RELEASE E-STOP')
            self.estop_btn.setStyleSheet(theme.ESTOP_ENGAGED)
        else:
            self.state_lbl.setText('READY')
            self.state_lbl.setStyleSheet(f'color:{theme.GOOD}; font-weight:800;'
                                         'font-size:11px; letter-spacing:2px;')
            self.estop_btn.setText('EMERGENCY STOP · Esc')
            self.estop_btn.setStyleSheet(theme.ESTOP_IDLE)
        self.estopToggled.emit(engage)

    @property
    def estop_engaged(self) -> bool:
        return self._estop

    def set_mode_display(self, mode: str) -> None:
        self.btn_manual.setChecked(mode == 'manual')
        self.btn_auto.setChecked(mode == 'auto')

    def set_servo_feedback(self, deg: int) -> None:
        if not self.servo_slider.isSliderDown():
            self.servo_slider.blockSignals(True)
            self.servo_slider.setValue(deg)
            self.servo_slider.blockSignals(False)
            self.servo_lbl.setText(f'{deg}°')

    def keyboard_vector(self, turn: float, fwd: float) -> None:
        """Keyboard drive path (held keys) — same stream as the joystick."""
        if self._estop:
            return
        if turn == 0.0 and fwd == 0.0:
            self.stopRequested.emit()
        else:
            self.driveRequested.emit(fwd * self._speed,
                                     turn * -self.prefs.turn_rate)

    def current_speed(self) -> float:
        return self._speed

    # ── internals ─────────────────────────────────────────────────────────
    def _joy_vector(self, turn: float, fwd: float) -> None:
        if self._estop:
            return
        if turn == 0.0 and fwd == 0.0:
            self.stopRequested.emit()
            if not self._estop:
                self.state_lbl.setText('READY')
        else:
            self.state_lbl.setText('DRIVING')
            self.driveRequested.emit(fwd * self._speed,
                                     turn * -self.prefs.turn_rate)
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
