GP-Golden-9/GP/(commit log)

2026-06-10 Phase 0-1: baseline tooling + root-cause stability fixes
    Phase 0: tools/baseline_probe.py measures video fps/frame-age and ROS topic
    inter-arrival; docs/baseline/ procedure with repro drills per root cause.
    Phase 1 root-cause fixes:
    - DDS isolation: ROS_DOMAIN_ID=11/12 per robot (cross-robot /cmd_vel leakage)
    - udev rules give stable /dev/rplidar + /dev/mega names (LiDAR/Arduino swap)
    - robot2.sh now launches tcp_rasp_zmq.py (q35/30fps/SNDHWM=1) instead of
    tcp_rasp.py (q80, unbounded queue) — video lag root cause
    - deadman-gated keepalive in both bridges: continuous drive no longer killed
    by the firmware watchdog, but a silent commander stops the robot in 0.8s
    - real end-to-end e-stop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
    [baseline_probe.py, mapper.yaml, robot1_bridge.py, robot2_bridge.py]
2026-06-10 Repo hygiene: proper .gitignore, LF enforcement for Pi-bound files
    - ignore __pycache__/pyc, logs, probe outputs, ESP32 secrets
    - .gitattributes forces LF on *.sh/*.rules/*.service/*.py so scripts
    copied to the Raspberry Pis never break on CRLF
    - drop tracked .pyc files from the index
2026-06-10 Phase 2a: gpcore package — protocol, serial parsing, kinematics, config, logging
    ROS-free shared core, pip install -e common, 60 unit tests green:
    - protocol: versioned msgpack envelope (v/seq/t_mono/t_wall/run_id/src/type),
    SeqTracker gap detection, command semantics (cmd_id ACKs, LRU dedupe,
    DriveDeadman), channel/port map + staleness model
    - serialproto: parsers for every Mega line format (D: v2/v4/v5, B:, both STS
    forms, OK:/ERR:) + command formatting (pump=U not W, servo clamp 10-170)
    - kinematics: DiffDriveOdometry extracted 1:1 from robot2_odom.py
    - nav: GotoController extracted 1:1 from robot2_goto.py (pure step())
    - config: fail-loud YAML loader with dotted-path errors
    - log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
2026-06-10 Phase 2b: per-robot gateway, supervised launch, systemd, consolidated config
    ROS islands architecture: each Pi sets ROS_LOCALHOST_ONLY=1 and talks to the
    laptop ONLY via the versioned ZMQ protocol:
    - gateway/zmq_server.py: ROS-free socket layer (PUB telemetry/map/health,
    ROUTER commands with cmd_id dedupe, drive deadman, crash-contained
    handlers) — 6 inproc roundtrip tests, no hardware needed
    - gateway/gateway_node.py: ROS topics <-> ZMQ channels; tele.full 20Hz,
    scan 5Hz, zlib map 1Hz, health 1Hz with stream freshness + Pi vitals
    - robots/robot2/nodes/camera_pub.py: ROS-free camera unit publishing framed
    video (capture timestamps) on 5560 + legacy 5555 during migration
    - robots/ro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
    [robot1.yaml, robot2.yaml, robot3.yaml]
2026-06-10 Phase 3: PySide6 operator console with sim mode
    Native Qt replacement for the NiceGUI dashboard (which stays runnable):
    - transport: RobotLink (SUB threads per robot, auto-reconnect) +
    CommandClient (DEALER, 300ms ACK timeout, x2 retry same cmd_id, 1Hz ping
    liveness, e-stop burst); Esp32Link presents the same signal surface
    - state: RobotState single-writer store, per-stream FRESH/STALE/DEAD sweep,
    video clock-offset estimate for true capture-to-display age
    - views: meter-space QGraphicsView map (grid/scan/pose/goal layers, wheel
    zoom, right-drag pan, click-to-goal), video blit with age+fps+AI badges,
    hold-to-drive control panel emitting the 10Hz drive stream, pump
    hold-button +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
    [main_window.py]
2026-06-10 Phase 4: robot2 firmware v5 — pump, arm servo, hardware e-stop
    Copy of v4 (kept intact for rollback) plus the intervention tools:
    - U1/U0 water pump on relay pin 7 (NOT 'W' — that's the watchdog toggle):
    5s max-run auto-off, 1s cooldown, forced off by watchdog timeout, E-stop,
    and boot; active-low relay boot-glitch guard (OFF level preloaded before
    pinMode OUTPUT)
    - A<deg> arm servo on pin 5: clamped 10-170°, slew-limited 120°/s (Servo
    lib claims Timer5 = pins 44-46, unused; ENA/ENB PWM unaffected)
    - E/X e-stop latch matching robot1 firmware; motion+pump gated while latched
    - D: packet appends ,pump,servo,estop (17 fields — backward compatible,
    old bridge indexes only 0-10;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
    [robot2_controller_v5.ino]
2026-06-10 Phase 5: robot3 ESP32 firmware v2 — inspector hardening
    - command watchdog (800ms): fixes the v1 drive-until-impact bug when WiFi
    drops mid-command; web UI now also re-sends the held direction as keepalive
    - WiFi self-healing: on disconnect, stop motors + audible chirp, retry every
    5s; mDNS advertises robot3.local (the hostname the dashboard targets)
    - gas alarm latched >=10s with hysteresis (3000 trip / 2000 clear, matching
    the field-tuned v1 threshold), pulsing buzzer works with no network
    - /telemetry adds rssi, uptime, last_cmd_age for the console health panel
    - WiFi credentials moved to gitignored config_secrets.h (+ template);
    v1 had the SSID/password committed in plaintext
    -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
    [robot3.yaml]
2026-06-10 Phase 6: protocol docs, demo runbook, soak/log tooling, README rewrite, attic
    - tools/soak_test.py: live KPI measurement vs acceptance gates (loss <1%,
    video >=12fps, age p95 <=350ms, ack p95 <=150ms...) with JSON report;
    validated against the simulator — all gates PASS
    - protocol fix found by the soak: seq counters are now PER MESSAGE TYPE,
    not per channel (interleaved tele.scan made gap detection report 20%
    phantom tele.full loss)
    - tools/collect_logs.py: one-command incident bundle (robot gp_logs by
    run_id + journalctl + laptop logs) for docs/incident_log.md entries
    - docs/protocol.md: full wire spec; docs/runbook_demo_day.md: roles,
    T-60/T-30 checklists, mid-demo recovery l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
    [collect_logs.py, soak_test.py]
2026-06-10 Remove dead files (recoverable from git history)
    - attic/: quarantined streaming experiments + nav2_params — nothing
    references them; history keeps them if ever needed
    - arduino robot2 firmware v1/v2/v3: superseded twice over (v4 remains as
    the flashable rollback for firmware/robot2_controller_v5)
    Kept on purpose: dashboard/dash.py (legacy fallback until the Qt console
    passes its parity gate on real hardware), robot3_controller.ino v1
    (rollback until v2 is flashed), mapping/start_mapping.py (dev-machine
    SLAM+RViz utility), NoMachine profiles.
2026-06-10 Console polish: keep D-pad buttons compact (centered, max 80px wide)
2026-06-10 Console redesign: cohesive dark design system + smoothness fixes
    New views/theme.py — single source for palette, app-wide QSS (Fusion base),
    Card component, chips, and Windows dark title bar:
    - branded toolbar (GP FLEET CONSOLE, section-labeled selectors, LINK/run
    chips), card-based layout with uppercase section titles
    - styled everything: D-pad (accent, compact), pump (water-blue), checkable
    AUTONOMOUS button, rounded EMERGENCY STOP states, sliders with accent
    fill + mono value labels, tabs, combos, scrollbars, splitters, group boxes
    - video badges are now translucent rounded pills with status dots
    (LIVE/fps/age, NO SIGNAL, AI ON / RAW·AI OFF)
    - map: themed palette via indexed co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
    [main_window.py, theme.py]
2026-06-10 Console: fire/gas alert engine, alert banner, bigger map, exit button, refactor
    Alerts (new alerts.py — engine separate from views):
    - AlertManager with operator-grade lifecycle: CLEAR -> ACTIVE -> ACKED,
    debounced raise (fire: >=3 detections >=50% conf within 2s; gas: 2
    consecutive alarm polls), auto-clear after 5s quiet, drill support
    - YOLO worker now returns (label, confidence) detections alongside the
    annotated frame; fire alerts feed from the active camera, gas alerts
    surface from ANY robot (robot3 telemetry), even while driving another
    - views/alert_banner.py: full-width pulsing banner under the toolbar
    (FIRE red / GAS amber), ACKNOWLEDGE button, steady gray when acked,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
2026-06-10 Real fire detection verified end-to-end; evidence-based tuning + worker fix
    Installed ultralytics + torch (CPU) and tested against real fire imagery
    (tools/test_fire_model.py, tools/probe_models.py). Measurements drove:
    - BUG (caught by the probe): substring label matching meant COCO's
    'fire hydrant' would raise the FIRE alarm — now exact-label matching,
    with a regression test
    - BUG: hang-watchdog killed the YOLO child during torch's slow first
    forward pass — child now runs a warm-up inference BEFORE reporting
    ready, timeout 5s -> 12s, respawn budget resets when healthy
    - model choice by measurement: fire.pt scores 28-37% on real fire with
    clean detections vs dual-head's 13-20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
    [fleet.yaml, main_window.py, probe_models.py]
2026-06-10 Operations Center: ground-up console redesign (dockable shell, shared map, detection projection, frame alignment, joystick teleop, remote diagnostics)
    New ui/ package replaces views/ entirely:
    - Docking shell: the MAP is the central widget and absorbs all free space;
    FLEET, LIVE FEED, OPERATIONS and the LOG/DETECTIONS/DIAGNOSTICS drawer
    are movable/floatable/hideable docks, layout persisted via QSettings
    - Map: 1m grid lines, adaptive scale bar, live cursor coordinates, robot
    name tags, motion trails (SLAM jumps become visible = lost-robot
    detection), layer toggles, FIT/FOLLOW, zoom clamp
    - Shared-map multi-robot model (ui/map/projection.py, unit-tested):
    robot1's SLAM frame is the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
    [alert_banner.py, bottom_panel.py, command_bar.py, diagnostics.py, fleet_panel.py, joystick.py, main_window.py]
2026-06-10 Path planning: robots route through doors, not into walls; map fit fixed
    Why robots hit walls: robot2_goto is deliberately a dumb straight-line
    controller. The intelligence now lives where the map lives — the console:
    - ui/map/planner.py: A* global planner over the occupancy grid (pure
    numpy). Hard inflation by robot radius + margin (the whole robot fits
    anywhere the path goes), soft cost rings near obstacles (paths cross
    doorways through their CENTER), no diagonal corner-cutting, unknown
    space is never traversable, goals clicked into walls snap to the
    nearest free cell, line-of-sight simplification yields sparse waypoints
    - ui/mission.py: MissionExecutor walks the robot leg by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
    [main_window.py, mission.py]
2026-06-10 Firmware professionalization: non-blocking parsers, honest watchdogs, OTA
    Audit findings fixed across all three robots' firmware:
    - robot2 v5: serial commands now accumulate in a non-blocking line buffer
    (readStringUntil could stall the 50 Hz control loop up to 1 s on a
    partial/noisy line); diagnostics (?/I/V/H) no longer feed the watchdog —
    a status poller can no longer keep a half-dead system "alive"
    - NEW robot1_controller_v3: same two fixes for the mapper (its bridge
    polls '?' every second, which in v2 meant the safety timeout could
    NEVER fire while the bridge process was alive), consistent OK:/ERR:
    replies, protocol unchanged — drop-in for the flashed v2
    - robot3 v2: Ar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
    [robot1_controller_v3.ino, robot2_controller_v5.ino, robot3_controller_v2.ino]
2026-06-10 Professional README + console screenshot; scrub WiFi creds from legacy v1
    - README rewritten as the product front page: fleet table, Operations
    Center features, architecture diagram, four-layer safety chain, quick
    starts (sim-first), firmware/verification tables, honest limitations
    - docs/img/operations_center.png: live console screenshot
    - SECURITY: removed the plaintext WiFi SSID/password from the legacy
    robot3 v1 sketch (v2 reads gitignored config_secrets.h). NOTE: the
    credentials remain in OLD git history — rotate the WiFi password or
    keep the repository private.
2026-06-10 Gamma gas level surfaced everywhere it belongs; ESP32 pose bug fixed
    Answering "where is the gas level?": after the redesign only the gas ALARM
    surfaced — the live reading was nowhere. Now:
    - Gamma's FLEET CARD shows 'gas <adc> · <rssi> dBm' continuously (red at
    alarm/clear-threshold), visible regardless of which robot is active
    - status bar while Gamma is active: 'robot3 · gas N [· ALARM] · dist · rssi'
    - diagnostics vitals strip fed from ESP32 telemetry (rssi/uptime)
    Real bug found during the audit: the ESP32 link fed telemetry x/y — which
    are accelerometer TILT, not position — into the pose pipeline, so Gamma
    wandered the map by tilt noise. Pose is now pinned to the frame or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
    [alert_banner.py, main_window.py]
2026-06-10 Circuit manuals for all three robots; sim fleet split into 3 independent robots
    docs/wiring/ — professional wiring manuals built from the firmware pin
    definitions (the source of truth):
    - common rules: single ground node, master switch + fuse first, set bucks
    to 5.10V BEFORE connecting computers, motors never on the 5V rail,
    12V battery -> LM2596S step-down on every robot
    - robot1: dual L298N pin map (one channel per motor), power tree with
    Pi 4 current budget warning, lidar/mega udev identities, note that the
    JGB37 hall encoders exist but are unused by current firmware
    - robot2: L298N paired-channel map, all 8 encoder pins, GY-87 I2C, pump
    relay on D7 (battery-direct load throug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
2026-06-10 ESP32 firmware compile-verified — all three robots' firmware now build-checked
    robot3_controller_v2 compiles clean with arduino-cli for esp32:esp32
    (core 3.3.10): 1,046,770 bytes flash (79%), 53,648 bytes RAM (16%).
    Together with the earlier Mega verifications (robot1_v3 2% flash,
    robot2_v5 9% flash) every current sketch in firmware/ is proven to build
    before anyone stands next to a robot with a USB cable.
2026-06-10 Professional naming, dead-code removal, README aligned — fully re-verified
    Renames (history preserved via git mv):
    - "arduino/robot2_controller/robot2 controller v4 .ino" (spaces, trailing
    space!) -> arduino/robot2_controller_v4/robot2_controller_v4.ino —
    folder now matches the sketch, so the rollback actually builds in the
    Arduino IDE / arduino-cli
    - "project details.txt" -> docs/project_notes_ar.txt
    - ai/ design documents -> docs/design_notes/
    - robot.nxs, robot2.nxs -> tools/nomachine/ (+ README absorbing the old
    "restart nomachine.txt" lightdm one-liner)
    Removed (recoverable from git history):
    - dashboard/ — the legacy NiceGUI dashboard; the Operations Center
    replaced ev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
    [robot2.yaml]
2026-06-10 fix: restore 50Hz non-blocking ZMQ poll to fix telemetry rate regression
2026-06-10 fix: install global event filter for drive keys so MapWidget/sliders don't swallow them
    [joystick.py, main_window.py, ops_panel.py]
2026-06-10 fix: move sys.path.insert above gpcore imports
2026-06-10 feat: add RESET MAP button to dashboard to restart SLAM on robot
    [main_window.py]
2026-06-10 Harden the team's field fixes: reset_map routing, pose fallback, real cmd isolation
    Review of the 10 commits pushed from real-robot testing found four genuine
    bugs and several gaps — all fixed and re-verified:
    - gateway _pose_cb: the "keep true odom" guard did `pass` and fell through,
    so /pose ALWAYS overwrote live wheel odometry. Now returns.
    - RESET MAP: gateway restarted a hardcoded gp-robot1.service (wrong robot
    when sent elsewhere); console sent it to the ACTIVE robot. Now the console
    routes to whichever robot publishes the map, the gateway restarts its OWN
    gp-<robot>.service, and a confirm dialog guards the one-click stack
    restart. cmd.reset_map added to EXACTLY_ONCE so a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
    [command_bar.py, fleet_panel.py, main_window.py]
2026-06-10 robot1: supervise the LiDAR driver directly - fixes scan dead until reboot
    Live finding on the real robot (2026-06-11): rplidar_node aborted once at
    boot (RCLError, exit -6, serial port not yet settled) and the scan stream
    stayed dead for the whole session - health showed scan age 394 s and
    climbing while everything else was green.
    Root cause: the driver was started via rplidar_ros own rplidar_a1_launch.py,
    so our respawn=True never applied to it, and the scan_watchdog last
    escalation rung (pkill, "launch respawn brings it back") assumed supervision
    that did not exist.
    The launch now runs rplidar_node directly with respawn=True/3 s and the A1
    parameters inlined. Same hole closed in slam_on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
2026-06-10 scan_watchdog: stop killing a healthy LiDAR (startup grace + kill grace)
    Live journal from robot1 showed the true sequence behind "LiDAR fails to
    spin": the watchdog armed 0.3 s after the driver began scanning, read
    "0.0 Hz" while DDS was still discovering /scan (no startup grace,
    _last_action=0 let it act on its very first 1 Hz tick), stopped the healthy
    motor, blocked its own executor 2 s with time.sleep inside the kick (losing
    its own scan stamps), then escalated to pkill on a 5 s cadence - faster
    than the driver can respawn and reach scanning (~5 s) - and kill-looped
    forever. With the old launch (no driver respawn) the first kill was
    permanent; with respawn it became a 6 s kill loop. Obs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
2026-06-10 Teleop dead + map "frozen": root causes were one focus bug, not the renderer
    Field report: WASD/arrows did nothing and the map never updated while
    driving. Root cause chain: the model selector QComboBox was the ONLY
    focusable widget in the command bar, so it held focus from startup; the
    key filter exempted combo boxes wholesale, so every drive key went into
    the combo (arrows silently switched the YOLO model). The robot therefore
    never moved - and slam_toolbox correctly integrates nothing when the
    robot is stationary, so the 1 Hz map messages carried identical content:
    "frozen on the first frame".
    Fixes:
    - model/diagnostics combos are NoFocus like every other console control
    - key filter now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
    [command_bar.py, diagnostics.py, main_window.py, mapper.yaml]
2026-06-10 Move LiDAR map-quality research notes into docs/design_notes/
2026-06-10 Map crispness: 0.025 m SLAM resolution; gateway pose = map frame always
    Applied from the LiDAR research reports (docs/design_notes/): A1M8
    accuracy supports 0.025 m cells - doubles wall sharpness at console zoom.
    Gateway now always reports the SLAM robot position from map->base_link
    (drift-corrected, authoritative) and keeps /odom velocities, instead of
    only when stationary; robots without a map frame keep wheel odometry
    unchanged.
    [mapper.yaml]
2026-06-10 robot1: rf2o laser odometry feeds SLAM (the report fix for smeared walls)
    rf2o_laser_odometry (built from source in ~/ros2_ws - no Humble binary)
    now publishes /odom and a real odom->base_link transform from scan flow
    at 10 Hz; the static identity TF in slam_only.py is gone (publishing both
    would fight). slam_toolbox finally has motion input, which the LiDAR
    research reports identify as the root cause of doubled/smeared A1M8 maps.
    Unit template sources ~/ros2_ws/install/setup.bash when present, and
    install_systemd.sh now derives the service user from the repo owner
    instead of hardcoding pi (the live robot runs as muc).
2026-06-10 robot1 navigation: 180-deg laser TF fix, goto controller with LiDAR collision guard, footprint-accurate planning, smooth pose animation
    Field issues from live testing, each root-caused:
    - Arrow pointed backward: the A1 lidar 0-deg axis faces the chassis REAR.
    base_link->laser static TF now carries yaw=pi (the report-prescribed
    fix); the gateway adds footprint.laser_yaw_rad to tele.scan a0 so the
    console scan overlay stays base-frame correct.
    - Nav-to-goal never moved: NOTHING on robot1 subscribed /goal_pose -
    click-to-navigate was robot2-only by design. New navigation/
    robot1_goto.py: pose from map->base_link TF (goals arrive in that
    frame), rotate-then-drive, and a scan-based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
    [robot1.yaml]
2026-06-11 goto: do not count the robot own chassis as an obstacle
    Field failure minutes after deploy: every goal aborted BLOCKED:ROTATE.
    The lidar sits at the front of the 40 cm body and SEES the chassis rear
    deck at 0.15-0.30 m - inside the 0.38 m rotation-clearance circle, so the
    guard read "obstacle alongside" forever. Returns inside the footprint
    envelope (+3 cm slack) are now excluded before the corridor and rotation
    checks; everything outside the body still blocks as designed.
    [robot1_goto.py]
2026-06-11 goto: learn the robot own protrusions instead of hand-tuning a rectangle; planner: despeckle noise cells before inflation
    Scan probe on the live robot (10-scan persistence analysis) showed the
    rectangle exclusion matched NOTHING (inside_excluded=0). The real blocker
    is a fixture protruding 0.21-0.24 m at the front-left, present in every
    scan at a constant body position - inside the 0.38 m rotation circle
    (every BLOCKED:ROTATE) and exactly on the 0.21 m corridor edge (the
    flapping BLOCKED:AHEAD).
    The controller now learns a per-beam self-occlusion profile during its
    first ~2 s: beams persistently returning < 0.32 m are attached fixtures
    (the lidar cannot see past its own wheel anyway) and ar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
    [robot1_goto.py]
2026-06-11 goto: rotation guard by actual sweep geometry, not a naive circle
    Indoors a robot often sits within 0.38 m of SOME wall, so the full-circle
    rotation check vetoed nearly every rotation (field logs: BLOCKED:ROTATE
    on every goal even after self-masking). Geometry: the front corners only
    reach 0.18 m, so the front half-plane can never be struck by rotating -
    only the rear corners sweep 0.335 m. The guard now blocks rotation only
    for returns grazing the body side (< corridor_half anywhere) or in the
    rear half inside rotate_clear (0.38 -> 0.36). BLOCKED logs now include
    the nearest return position so diagnosis is data, not guesswork.
    [robot1.yaml]
2026-06-11 goto: tight-space maneuvers - arc turns and guarded reversing
    Field logs with the new nearest-point diagnostics showed the remaining
    failures were all genuine tight quarters (walls 0.26-0.33 m to the side;
    the rear corner sweeps 0.335 m, so pivoting there really would clip).
    Operator-visible symptoms: "only goes forward", "cannot go to a place
    behind".
    Instead of holding and aborting, the controller now maneuvers like a
    driver in a narrow lane:
    goal to a side -> arc turn (creep 0.06 m/s forward while turning; the
    rear tracks inside the front path, guarded by the
    forward corridor check)
    goal behind -> reverse toward it, steering the rear at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
    [robot1_goto.py]
2026-06-11 goto: self-mask hardening - distance band, size cap, tighter bound
    A restart while parked near walls masked 376 beams (half the scan) and a
    masked beam ignored anything CLOSER than the learned range - an
    approaching wall on those beams was invisible. Now: (1) masked beams drop
    only returns within a 6 cm band of the fixture distance, so anything
    sliding in closer trips the guard again; (2) a mask covering > 25% of the
    scan means the robot booted against environment and is refused outright;
    (3) fixture bound tightened 0.32 -> 0.28 (measured fixture: 0.21-0.24).
    [robot1_goto.py]
2026-06-11 goto: probing rotation + measured left-fixture exclusion pocket
    The left-side blocker tracked at a CONSTANT body position (x=-0.02..+0.12,
    y=+0.21..0.24) through every pivot, translation and goal tonight - it is
    attached hardware (cable or bracket past the body edge), but it shifts
    between boots so the per-beam boot mask sometimes misses it. Two layers:
    1. A documented exclusion pocket for that measured zone.
    2. PROBING ROTATION as the general fallback when the pivot guard trips on
    an ambiguous close blocker (0.16 m floor): rotate at 0.15 rad/s and
    watch it - attached hardware turns with the robot (distance constant,
    rotation completes); a real obstacle closes in (3 cm trend) and t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
    [robot1_goto.py]
2026-06-11 goto: widen the left-fixture pocket to its full observed envelope
    The attached signature reaches x=+0.20 (it also clipped the DRIVING
    corridor, blocking AHEAD): pocket now x=-0.15..0.23, y=+0.15..0.28.
    TEAM ACTION stands: tuck that cable/bracket out of the scan plane and
    shrink this pocket away.
    [robot1_goto.py]
2026-06-11 robot2 odom: pure-encoder heading when the IMU reads dead zeros
    Live finding on robot2 (2026-06-11): the GY-87 is not responding on I2C
    (firmware INIT: MPU6050 FAIL, magnetometer FAIL), but the bridge still
    publishes /imu/data_raw with raw ZEROS - fresh-looking messages, so
    staleness checks cannot catch it. The complementary filter then blended
    70% of nothing into heading: every turn registered at 30% of its true
    angle and dead-reckoning was useless.
    A live MPU has a noise floor (raw values always jitter); only a dead chip
    reads exactly zero on all six axes. After ~1 s of all-zero messages the
    filter falls back to pure encoder heading (loudly), and restores gyro
    blending automatically if th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
    [robot2_odom.py]
2026-06-11 robot2_bridge: bound the boot-banner drain - v5 streaming made it infinite
    Root cause of "robot2 publishes nothing": v5 firmware streams D:/B:
    telemetry at 50 Hz, so the unbounded `while in_waiting:` drain in
    _connect_arduino never went quiet. The constructor sat in that loop
    forever - 8,900+ journald lines logged in minutes on the live robot, the
    serial reader thread never started, and /encoders, /imu/data_raw and
    /odom stayed silent while everything LOOKED healthy (topics existed,
    services active). The drain is now time-bounded (3 s) and skips
    telemetry lines; only the boot banner and INIT results are logged.
    [robot2_bridge.py]
2026-06-11 robot2: real kinematics (85 mm wheels) + skid-steer turn tuning
    Team measurements (2026-06-11): chassis 30x20 cm, wheel diameter 85 mm.
    The odometry node was hardcoded to 65 mm - every distance under-read by
    24%. Kinematics now load from config/robot2.yaml drive: (wheel 0.085,
    track 0.225 estimated with a documented spin-calibration procedure,
    ticks 330). Footprint added for the planner (hard inflation 0.15 m).
    Turning was jerky and strained the motors; root causes in _twist_to_cmd:
    (1) PWM was only ever set from LINEAR speed - pivots ran on stale, often
    minimal PWM, and four skid-steering wheels at PWM~120 stall-judder;
    (2) the linear>angular arbitration flapped F-L-F mid-drive whenever th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
    [robot2.yaml]
2026-06-11 robot2_bridge: announce motor stalls instead of silently grinding
    Live test: pivot commanded at PWM 215, e-stop clear, commands confirmed
    applied on the Mega (STS echoed P215) - encoders frozen. Skid-steer
    pivot friction plus an under-voltage battery (get_throttled=0x50005)
    stalls the motors with no feedback to the operator. The bridge now
    watches encoder deltas while motion is commanded and raises MOTOR STALL
    on the robot log (console incident feed) after 1.5 s of frozen wheels.
    [robot2_bridge.py]
2026-06-11 Raise fire alarm gate to 0.80 (operator request after night false alarms)
    Documented trade-off in fleet.yaml: fire.pt measures 28-37% on REAL fire,
    so at 0.80 the audible alarm is effectively drill-only (F9) until a
    better-trained model separates the 26-39% overlap between real fire and
    night-room false positives. Detections table still shows everything.
2026-06-11 preflight: tolerate the boot-inrush undervoltage blip, block only if it persists
    After the team fixed robot2 power (1000 uF caps at buck + Pi, re-gauged
    cable, 5.22 V verified), the rail reads clean seconds after boot
    (0x50000) - but preflight runs DURING USB+WiFi enumeration inrush and
    sampled 0x50005, blocking a now-healthy robot. The power gate now samples
    up to 3x over 10 s and fails only if undervoltage PERSISTS; a genuinely
    sagging supply still blocks exactly as before. Applied to both robots.
    [usage-report.csv]
2026-06-11 robot2: ticks_per_rev 330 -> 408 per 25GA370 spec; file research docs
    The team research doc (now in docs/design_notes/) carries the official
    25GA370 encoder spec: 12 PPR x 34:1 gearbox = 408 counts/wheel-rev at 1x
    decoding - exactly what the firmware ISR counts (RISING on A only). The
    old (65 mm, 330) pair was an empirical calibration whose errors nearly
    cancelled; after the wheel was corrected to the measured 85 mm, the
    stale 330 alone inflated distances 24%. Both halves now match physical
    truth. Also dropped an unrelated DNS zone export that slipped into the
    repo root (moved next to the repo, gitignored).
    [robot2.yaml]
2026-06-11 Drop throwaway lag probe that slipped into the previous commit
2026-06-11 robot2: drive PWM floor - default speed could not move the chassis
    Direct-serial test proved motors/L298N/battery healthy (PWM 255 -> all
    four wheels, deltas ~400-600 ticks/0.8s) while the console at its DEFAULT
    speed produced zero motion: the 80..255 PWM mapping put the default
    slider at ~PWM 132, below static friction. Drive PWM now maps
    min_pwm(150)..255 so every slider position produces real motion.
    (Hardware note: the no-motion-at-all episode was the ENA/ENB enable
    wires, re-seated by the team.)
    [robot2.yaml]
2026-06-11 robot2_bridge: actually apply min_pwm in the drive mapping (missed in 77514e1)
    [robot2_bridge.py]
2026-06-11 Drop session throwaway probes
2026-06-11 systemd: purge stale FastDDS shared-memory segments on every stack start
    Root cause of "gateway ACKs commands but the robot never moves":
    brownout crash-loops left stale FastDDS SHM segments in /dev/shm; with
    localhost-only DDS the SHM transport silently dropped every message
    while discovery still matched (bridge executor idle, 695 commands ACKed
    by the gateway and never delivered; proven by py-spy stack dump plus a
    direct-serial motor test, both healthy). Purging the segments restored
    delivery instantly; both robot units now do it in ExecStartPre, where
    nothing else can own them.
2026-06-11 docs: full field debugging and hardening report, 2026-06-10/11
    1,100+ line engineering report covering both robots and the console:
    26 incidents, each with symptom, investigation, root cause, fix (commit),
    verification and lesson. Includes cross-cutting lessons, a verification
    matrix, demo-day recommendations, the complete commit log, a diagnostic
    cookbook (power truth, direct-serial motor splitter, SHM purge, py-spy,
    gateway counters), calibration tables and the Pi power-delivery reference.
2026-06-11 Console-only fleet ops: SHUTDOWN + STOP STACK buttons, lidar idle hold
    Operator goal: never SSH into a Pi for normal operation. Added:
    - SHUTDOWN button per robot (clean sudo shutdown -h; safe for the SD
    card before charging) and STOP STACK (robot fully idle; START is the
    existing RESTART STACK).
    - Diagnostics SSH actions used a hardcoded pi@ user - broken against the
    real fleet (runs as muc). User now comes from robot config
    (robot.user), default muc.
    - LiDAR idle hold: the A1 motor is wired to the USB adapter DTR line and
    spins forever whenever the robot is powered, even with nothing using
    it. New gp-lidar-idle.service holds the port with DTR asserted (motor
    off) whenever gp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
    [robot1.yaml, robot2.yaml]
2026-06-11 Header readiness dots clarified; collect_logs cp1252 + user fixes
    - Robot pills in the command bar already carry per-robot readiness (the
    1 Hz command-channel heartbeat - stronger than ping: green means the
    software answers commands). Made it discoverable: bigger dots and a
    tooltip that states READY / OFFLINE / connecting with the reason.
    - COLLECT LOGS crashed on Windows consoles (cp1252) printing a unicode
    box-drawing rule - operator-reported with traceback. ASCII now, and
    the tool default user fixed pi -> muc (second place that assumed the
    wrong fleet user).
    [collect_logs.py, command_bar.py]
2026-06-11 lidar idle: one-directional hand-off - Conflicts= was killing the stack
    Conflicts= is bidirectional: when the idle holder started (legitimately,
    via the stack stop-hook, or racing a quick restart), systemd would stop
    gp-robot1 right back - observed live twice ("Job canceled" on deploy;
    the operator RESTART STACK silently undone minutes later). Now the
    stack evicts the holder in ExecStartPre (root +) and the holder never
    fights back: if it starts while the stack runs it finds the port busy
    and exits 0.
2026-06-11 Header pills: three-state readiness (READY / ON NETWORK / UNREACHABLE)
    Operator question that drove it: "robot is on the network but not
    started - I did not know until I pinged. Why?" The pill dot conflated
    "Pi off" with "Pi on, stack stopped". A background TCP prober (port 22
    for Pis, HTTP port for the ESP32, 5 s period) now feeds the layer below
    the heartbeat: green = commands acknowledged, AMBER = host reachable
    but stack not running (tooltip points at Diagnostics -> RESTART STACK),
    red = unreachable, gray = connecting.
2026-06-12 DDS: force UDP-loopback transport, disable shared memory on the robots
    Second silent-delivery failure in two days, each with a DIFFERENT SHM
    state (day 1: stale crash segments ate messages; day 2: a boot came up
    with subscriptions deaf and no segments at all). Same fingerprint both
    times: discovery matched, executor idle waiting, gateway ACKing operator
    commands that never arrived at the bridge.
    FastDDS SHM on these Pis is a per-boot lottery. Both robot units now pin
    FASTRTPS_DEFAULT_PROFILES_FILE to a profile with UDPv4 only and
    useBuiltinTransports=false: microsecond cost, whole failure class gone.
    The ExecStartPre purge stays as belt-and-braces for stray segments.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
2026-06-12 Drop session probes
2026-06-12 robot2_bridge: survive USB re-enumeration - the true serial root cause
    Hardware truth found: /dev/ttyUSB0 was RE-CREATED minutes after boot -
    the Mega USB link drops and re-enumerates intermittently on robot2. The
    reader thread swallowed the resulting exceptions and spun on the stale
    handle forever: encoders/IMU/STS froze, drive characters went into a
    dead tty, and the robot "stopped responding" while every process looked
    healthy. This single fault masqueraded as SHM corruption (06-11) and as
    discovery lease loss (06-12) because a service restart - which reopens
    the port - cured all three theories equally.
    The reader now treats any exception OR 3 s of line silence (firmware
    streams at 50 Hz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
2026-06-12 SET POSE: plain click repositions without resetting heading
    A release without a drag used to commit heading 0.0 - silently snapping
    the robot to face east, which is exactly the "starts inverted" symptom
    the operator is fighting on Beta (dead-reckoned odom has no absolute
    heading reference; theta=0 is just whichever way it faced at power-on).
    Now NaN flags "keep heading": the canvas emits it on a dragless release
    and the main window substitutes the robot's current displayed heading.
    Drag still sets heading explicitly. Tooltip + mode hint spell out the
    press-where-it-IS / drag-where-it-FACES gesture.
    [main_window.py]
2026-06-12 robot2 carpet-slip defense: odometry slip gate + PWM soft-launch ramp
    Two layers against wheelspin on carpet (operator report 2026-06-12:
    wheels spin in place, odometry registers movement while stationary):
    CORRECT (robot2_odom): slip gate in the heading filter. When the
    encoder-implied rotation rate disagrees with the gyro by more than
    drive.slip_gate_rad_s (0.6), the wheels are scrubbing: the gyro takes
    heading 100% (instead of leaking 30% phantom rotation through the
    complementary blend) and the distance estimate is scaled by the ratio
    of real-to-claimed rotation, since the same slipping ticks inflate it.
    Logged as WHEEL SLIP at most every 2 s with an event counter.
    PREVENT (robot2_brid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
    [robot2.yaml]
2026-06-12 Fix drive-replay overshoot; gyro bias auto-cal; goto stuck watchdog
    OVERSHOOT (operator: "1 s of command drives 2-3 s, sometimes perfect"):
    two compounding bugs in the command path, both fixed.
    1. dashboard_qt/transport/zmq_link.py - cmd.drive was RETRIED on ACK
    timeout like everything else. A retried drive delivers an obsolete
    stick position after a WiFi hiccup; cmd.drive is not in EXACTLY_ONCE
    so the gateway re-executed every duplicate. Drives (and pings) are
    now never retried - the 10 Hz stream is its own retry, the deadman
    covers total silence.
    2. gateway/zmq_server.py - poll_commands executed the entire post-stall
    DEALER flush in order, each stale drive re-arming the d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
    [robot2_goto.py, robot2_odom.py]
2026-06-13 docs: robot3 ESP32 FTDI flashing runbook
    Confirmed-working procedure for flashing Gamma through an FT232RL (the
    onboard USB-serial is dead). Captures the FTDI->ESP32 wiring, the 3.3V
    jumper + power-separately caveats that actually made it connect, the
    GPIO0/EN boot-mode sequence, and the firmware-specific strapping-pin
    gotcha (ECHO on GPIO5, buzzer on GPIO15 - flash with peripherals off).
    Notes that ArduinoOTA makes this a one-time cost. Distilled from the
    2026-06-13 flash session so the next loose-wire day is quick.
2026-06-13 robot3: add slew-limited servo (GPIO19) + endpoint/telemetry/web slider
    Gamma's hardware is 4 motors (two L298N channels), 1 ultrasonic, 1 servo,
    MQ gas, MPU6050 IMU, no wheel encoders. This adds the servo the build was
    missing:
    - ESP32Servo on GPIO19 (free, non-strapping - won't disturb FTDI flashing)
    - /servo?deg= HTTP endpoint, clamped 0-180, ACKs OK:<deg>
    - servo angle added to /telemetry; slider added to the standalone web UI
    - SLEW-limited in loop() (~150 deg/s) so a big move spreads its current
    draw instead of one brownout-inducing lunge - this build has a power
    history. Servo HOLDS position on WiFi loss (a frozen arm angle is safe;
    motors still stop on the watchdog).
    - LEDC tim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
    [robot3_controller_v2.ino]
2026-06-13 robot2: two front ultrasonics — sense, publish, and gate forward motion
    Beta has no lidar, so two front HC-SR04s become its real-time obstacle
    sense across the whole stack:
    FIRMWARE (robot2_controller_v5.ino): two HC-SR04 on free pins 30-33,
    read ROUND-ROBIN (one per 30 ms tick) so they never fire together (no
    cross-talk) and only one bounded ~8.7 ms pulseIn lands per loop; 3-deep
    median per side rejects fliers. Appended to the D: packet as ,usL,usR
    (cm; 150 = clear / no echo / disconnected — fails to "clear", never to a
    phantom wall). Backward compatible: old bridges index only field 0-10.
    BRIDGE (robot2_bridge.py): parses fields 17/18 (guarded on packet
    length), publishes sensor_msgs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
    [robot2.yaml]
2026-06-13 Add CLAUDE.md portable project context + cross-device sync guide
    Makes the project openable on any device with full context: CLAUDE.md
    (repo root) is auto-loaded by Claude Code and carries the durable
    knowledge — fleet, ZMQ/DDS architecture and the transport fix, repo
    layout, run/deploy procedures, conventions, current hardware state and
    open tickets — with ALL secrets stripped out (creds live in the
    gitignored config_secrets.h; SSH keys/passwords and chat transcripts are
    never committed). docs/claude_context_sync.md explains the workflow on a
    second device. .gitignore now excludes machine-local
    .claude/settings.local.json.
2026-06-13 Add redacted memory snapshot under .claude/memory/
    Git-committed, redacted copy of the project's Claude auto-memory so the
    full engineering history travels with the repo: DDS root cause + transport
    fix, power-delivery findings, robot2 motion fixes, robot2 ultrasonics,
    robot3 flashing + over-voltage outcome, open hardware tickets, console
    fleet ops. Access secrets (passwords, OTA keys, passwordless-sudo
    specifics) are stripped — they remain in the gitignored config_secrets.h
    and the team key store. The live unredacted memory stays on the operator's
    machine.
2026-06-13 docs: redacted engineering chat log
    Human-readable, secret-scrubbed record of the Claude Code sessions
    (fleet bring-up, the DDS root-cause hunt + transport fix, robot2 motion
    fixes, robot3 ESP32 flashing + over-voltage outcome, robot2 ultrasonics,
    cross-device portability). A curated reconstruction by topic, not a raw
    .jsonl dump — all credentials are placeholders; the raw transcript stays
    off git because it contains plaintext passwords.
2026-06-15 systemd: stop gating the localhost stack on network-online.target
    Root cause of "robot2 only moves ~3 minutes after boot": gp-robotN
    Requires= gp-preflight, and gp-preflight had Wants=/After=
    network-online.target. That pulls in NetworkManager-wait-online, which
    blocks until WiFi fully associates OR its ~120 s timeout fires — so on a
    slow/flaky-WiFi boot the ENTIRE stack sat idle for ~3 min before the
    bridge/odom/goto/gateway even launched.
    It's pure dead time: after the DDS transport fix the ROS nodes are
    localhost-only and the bridge talks to the Mega over USB — nothing needs
    the network to start, and the gateway's ZMQ sockets bind before WiFi is
    up and accept the console once it is.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
2026-06-15 tools: one-shot deploy_and_verify.sh (pull + refresh units + restart + check)
    Makes the network-online fix (and any pending Pi-software change) a single
    command on the robot: git pull, re-run install_systemd.sh so the corrected
    unit actually lands in /etc/systemd/system (a plain pull does NOT update the
    installed copy), restart the stack, then print systemd-analyze critical-chain
    so you can see network-online.target is gone. Firmware is flashed separately.
2026-06-16 robot2: cut Pi load + fix Mega serial startup so the map tracks live
    The Pi 3B+ was CPU-saturated (load ~6.5, 80 C throttle): the odom->gateway
    ->telemetry chain was starved so the map pose trailed real movement while the
    standalone camera stayed smooth. Lighten the Pi:
    - bridge: wait for real D:/B: streaming before declaring "connected" instead
    of the instant the boot banner drains. The Mega DTR-resets on port open and
    its setup() (GY-87 IMU init) takes a few seconds; the old 3 s silence timer
    tripped first and reconnected, re-resetting the Mega in a loop that took
    ~2 min to escape (map frozen the whole time). Death-detector 3 s -> 5 s so a
    brief stall under motor load no longer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
    [robot2.yaml]
2026-06-16 dashboard: low-latency console + laptop-side odometry + multi-class detection
    Operator console work, tested live on Beta (camera smooth, map tracks
    movement in real time):
    Latency / transport
    - zmq_link: coalesce telemetry bursts to the NEWEST pose. Beta's WiFi stalls
    then floods; replaying the stale-pose backlog after each stall made the map
    trail then jump. Can't use ZMQ CONFLATE (the socket also carries scans), so
    drain-and-keep-latest per wakeup; scans/log still emitted in order.
    - video decoupled from inference: show the RAW frame the instant it arrives
    and draw detection boxes as a vector overlay (video_panel) - video is now
    network-latency only, not gated by YOLO. Worker st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
    [bottom_panel.py, fleet.yaml, main_window.py]
2026-06-16 robot2: map-aware autonomous navigation + dashboard proximity/layout
    Two-layer nav stack for Beta (no lidar): the laptop does the map-aware global
    planning, ONE lean Pi node does reactive ultrasonic avoidance — they fuse so
    Beta plans around MAPPED obstacles and dodges UNMAPPED ones.
    - Pi has no /odom (moved to laptop), so goal-attraction can't run there. The
    laptop streams a heading bias (new CMD_NAV_BIAS -> /cmd_vel_bias); the new
    navigation/robot2_local_nav.py fuses it with a repulsion field from the two
    front ultrasonics. It is the SOLE /cmd_vel publisher, replacing the old
    robot2_goto + robot2_autonomous (which fought over /cmd_vel). 10 Hz, no
    pose/map math — lean enough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
    [robot2.yaml]
2026-06-16 robot2: slider speed cap, autonomy heartbeat-stop, 50 Hz heading
    - bridge: the speed slider (/set_speed) is now the authoritative top-speed CAP
    applied to BOTH manual and autonomous (it was overwritten before, so it did
    nothing and autonomous ran flat-out into walls). Autonomous gets gentler
    dedicated ceilings (auto_fwd_max_pwm 185, auto_turn_pwm 205).
    - local_nav: SAFETY heartbeat. WANDER drives autonomously on the Pi, so closing
    the console used to leave it driving (had to reboot to stop). The console now
    re-affirms AUTONOMOUS at 2 Hz; if that heartbeat goes stale (closed/crashed/
    WiFi lost) the node STOPS within ~2 s.
    - gateway: integrate heading at 50 Hz in the IMU callback (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
    [robot2.yaml]
2026-06-16 dashboard: telemetry latency fixes, Pi-heading, marker bounding, master-slave mission demo
    Latency (map/ultrasonic lagging after a while):
    - Render telemetry off the LATEST frame on a 30 Hz timer (_render_telemetry)
    instead of per-frame in the callback, so a busy UI thread can't back up the
    map/readout pipeline (store gains a _tele_rev counter).
    - ops_panel.set_ultrasonic only re-styles the proximity bars on a colour-band
    change (per-frame setStyleSheet was forcing a full style re-polish).
    - map_widget: cap markers at 40 + expire after 120 s (PINs kept) so the scene
    stays bounded and the render doesn't slow over a long session; also suppress
    markers projected OUTSIDE the mapped are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
    [main_window.py, mission_panel.py, ops_panel.py]
2026-06-17 dashboard: full master-slave demo scenario + operator usability fixes
    Master/Slave mission (pure simulation) extended to the full graduation scenario:
    - robot1 returns to base -> commands robot2 to navigate & find objects -> robot2
    detects FIRE -> goes to extinguish -> 5 s operator-INTERRUPTIBLE pump countdown
    (auto-fires if not interrupted) -> robot1 commands robot3 to the fire to read
    the GAS level -> done. Exact "robot1 sent an action to robot2 ..." log style.
    - mission_panel: GAMMA + GAS status pills, INTERRUPT PUMP button (lit only during
    the 5 s window). master_mission: countdown + interrupt_action + Gamma step.
    Operator usability:
    - map: clamp robot icons to the mapped extent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
    [main_window.py, mission_panel.py, ops_panel.py]
2026-06-17 Fix stale distance-clamp test + decouple gp-camera from network-online
    Two small follow-ups to the latest batch:
    1. tests/test_projection.py: the multi-class detection work raised
    DIST_MAX 4.0 -> 6.0 in projection.py but left the clamp test asserting
    4.0, so main was red. Align the assertion to the intended 6.0.
    2. systemd/robot2/gp-camera.service: drop After=network-online.target —
    the same ~3-min slow-WiFi boot wait the gp-robot2/preflight fix already
    removed. The camera publisher binds a ZMQ PUB socket to a wildcard and
    streams on subscriber connect; it never needs the network "up" to start.
2026-06-17 robot2: fix accumulating serial lag (the "crashes into walls after 1 min")
    Root cause of "odometry fine for a minute, then all readings lag and the
    robot drives into walls the ultrasonic still thinks are far": the bridge's
    serial reader processed EVERY line FIFO — 5 ROS publishes + 3 clock reads
    per D: packet at 50 Hz on a Pi 3B+. When the consumer can't quite hold
    50 Hz, the kernel serial buffer fills and every readline() returns
    progressively OLDER data. The buffer absorbs the slack for ~1 min, then
    every sensor reading is seconds stale: the ultrasonic guard sees a wall
    that's already been hit, and the laptop odom integrates a stale gyro with
    a wrong dt -> corrupted heading. Not heat —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
    [robot2_bridge.py, robot2_local_nav.py]
2026-06-18 robot2: fix yaw drift — integrate heading in the bridge at true 50 Hz
    Field 2026-06-18: hand-rotate Beta right-centre-left-centre and the map
    heading drifts ~45 deg though the robot physically returns to start.
    Cause: the drain fix made the bridge publish /imu only for the latest
    drained packet, so the gateway's heading integrator lost the intermediate
    50 Hz gyro samples — and integrating an angular RATE with dropped samples
    loses angle on every turn. The gateway also used a wall-clock dt, which
    jitters now that it sits near 100% CPU.
    Fix: integrate yaw in the BRIDGE, from EVERY packet (cheap scalar math, in
    the drain loop before anything is dropped), using the Mega's own millis()
    time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
    [robot2_bridge.py]
2026-06-18 robot2: gyro scale-factor calibration to remove residual yaw drift
    After the 50 Hz heading fix the remaining drift (~3% of total rotation) is
    the MPU6050's per-unit scale tolerance — proportional to ANGLE turned, not
    time, so it's a scale error, not bias. One per-robot number cancels it.
    - config drive.gyro_scale_correction (default 1.0) applied to the bridge's
    heading integration.
    - tools/yaw_calib.py: read-only telemetry reader that unwraps the robot's
    heading into a running total so you rotate a known angle (e.g. 360) and it
    prints the correction factor to paste into config.
    Note: this is the residual after the big fix; autonomous turns are slow and
    limited so mission-time drift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
    [robot2.yaml]
2026-06-18 robot2: set measured gyro_scale_correction 1.0304
    tools/yaw_calib.py over 3 full turns: 1048.2 deg read for 1080 actual ->
    the MPU6050 under-reads ~3%, factor 1.0304. Cancels the residual yaw drift.
    [robot2.yaml]
2026-06-18 Live Beta hand-off executor + odometry-safe smooth-motion tuning
    HAND-OFF (real): ui/live_handoff.py sequences the EXISTING pieces — global
    A* over Alpha's shared map (console-side, footprint-inflated) + the mission
    executor's bias stream + ultrasonic local avoidance + the pump — into Beta's
    scenario leg: navigate to the operator-dropped fire marker -> 5 s
    interruptible pump (firmware-capped too) -> return to start. Refuses to run
    unless Beta is map-aligned, a map exists, and a FIRE/PIN target is placed —
    never drives toward a placeholder. Disarms Beta during the pump so it holds
    instead of wandering; arms only during nav legs; re-entrancy-guarded abort/
    interrupt. MissionPanel gains a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
    [robot2.yaml]
2026-06-18 Replace master/slave mission with a simple FIRE TEST: place fire -> Beta goes
    The master/slave simulation + live hand-off were the wrong shape for the
    test the operator actually wants. Replaced with a minimal, real flow:
    ui/fire_panel.py — PLACE FIRE (click the map to drop the fire point) ->
    GO TO FIRE (Beta navigates there autonomously) -> STOP. Status shows
    IDLE / EN ROUTE <dist> / ARRIVED / NO PATH / STOPPED.
    GO reuses the EXISTING real nav (_plan_and_run): A* over Alpha's shared map
    (footprint-inflated) + the mission executor streaming the smooth, odometry-
    safe bias + Beta's ultrasonic local avoidance + replan-on-stuck. Arms Beta's
    autonomy + heartbeat for the run and disarms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
    [fire_panel.py, main_window.py, mission_panel.py]
2026-06-18 robot2: stall-disarm (anti-lockup) + autonomous back-off/reorient escape
    INFINITE-LOOP / 30 s LOCK-UP FIX (bridge): the real cause is an undervoltage
    cascade — a stalled motor pulls locked-rotor current, the rail sags, the Pi
    browns out/throttles, and control queues up for ~30 s. Fix: when the wheels
    stay frozen under a drive command past stall_disarm_s (1.2 s), kill the motors
    and latch a cooldown (stall_cooldown_s 2 s) that BLOCKS the same grinding
    direction — a DIFFERENT direction is allowed immediately so the robot can
    escape. Re-arms each cooldown, so driving into a wall becomes brief
    stall→stop→release bursts instead of one current-pinned lock-up. Works for
    manual AND auto (sin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
    [robot2_bridge.py, robot2_local_nav.py]
2026-06-18 robot2: stall_disarm_s 1.2 -> 3.0 s (operator preference)
    More tolerant of slow legitimate starts/brief pivot scrubs before disarming.
    Tradeoff: motors grind ~3 s before the safety cut, so the brownout margin is
    smaller — fine if the rail is solid; revisit if the lock-up reappears.
    [robot2_bridge.py]
2026-06-18 docs: field fixes + runbook for the team (through 2026-06-18)
    Adds docs/field_fixes_and_runbook_2026-06-18.md — every error we hit and its
    root-cause fix (serial-lag wall-crashes, yaw drift, the 30 s stall lock-up,
    slow boot, the GY-87 IMU dropout, the DDS root cause), how to RUN the
    autonomous FIRE TEST, the git-bundle deploy procedure for Beta, and the open
    hardware tickets. Updates the redacted .claude/memory snapshot + CLAUDE.md
    current-state to match. No secrets (creds stay in gitignored config_secrets.h).
2026-06-18 docs: team guide for using the Claude Code CLI on this project
    docs/using_claude_code.md — install/start, what Claude can do here (deploy,
    diagnose, run the dashboard), copy/paste prompt starters, the conventions it
    follows (no secrets, bundle-deploy for Beta, install_systemd for unit changes),
    and safety notes (e-stop is yours, IMU dropout). Linked from CLAUDE.md.
2026-06-18 robot2: encoder-heading fallback when the GY-87 gyro drops out
    The GY-87 falls off the I2C bus intermittently; the firmware then streams the
    last gyro reading IDENTICALLY every frame (not zero), so the old all-zero
    dead-detect missed it and heading froze. Now the bridge detects the FROZEN
    signature (identical raw gx/gy/gz for >=25 samples, or all-zero) and falls
    back to integrating the WHEEL DIFFERENTIAL — so driven turns still update
    heading through a dropout. Auto-restores to the gyro on recovery, logged both
    ways. Software-only (kinematics loaded from config); deploy via pull+restart.
    Note: encoder heading only updates when wheels TURN (won't track a hand-
    rotation) and is only as good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
    [robot2_bridge.py]
2026-06-18 dashboard: area-coverage path generator (the reference path for Beta)
    Pure, tested module: turns Alpha's occupancy grid into a boustrophedon
    'cover the area' route (world waypoints, walls inset by a margin, snaking
    rows). This is the SUGGESTED reference path — Beta follows it via the existing
    bias+ultrasonic fusion, which already deviates around obstacles and merges
    back. Foundation for the SCAN phase; wiring + deviation viz + master/slave
    approval gates next. 5 unit tests.
2026-06-18 dashboard: AUTONOMY panel — independent SCAN and FIRE sequences + reference-path viz
    Two independent operator-triggered autonomous actions (panel renamed
    FIRE TEST -> AUTONOMY), both real on Beta, sharing the mission executor via a
    small sequence state machine (_seq: scan_cover|scan_return|fire_go|fire_pump|
    fire_return):
    - SCAN AREA: generate a boustrophedon coverage path over Alpha's map
    (coverage.py), Beta follows it as a GUIDE, then returns to base.
    - GO TO FIRE -> PUMP 5s -> RETURN: navigate to the placed fire marker, hold +
    pump exactly 5 s (firmware also hard-caps), then return to the start pose.
    Reference-path visualization: the suggested route is drawn as a PERSISTENT
    dashed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
2026-06-18 robot2: faster auto-mode rotation (operator request)
    auto_turn_pwm 200->235 (pivot motor PWM) and goto.max_angular_rps 0.25->0.35
    (commanded turn-rate cap). Moderate bump so turns are snappier without
    reintroducing the wheel slip the odometry-safe tuning was avoiding; the slip
    gate + gyro scale-cal absorb the rest. The speed slider still scales the auto
    PWM, so push it up for even faster.
    [robot2.yaml]
2026-06-18 AUTONOMY panel -> dock (map always visible); robust commit-forward escape
    UI: the AUTONOMY panel moved from a center TAB to a right-side DOCK (tabbed
    with OPERATIONS), so the MAP stays visible while running the autonomy flow.
    LAYOUT_VERSION bumped so the old tab layout is discarded.
    ESCAPE (local_nav): "gets stuck in place when it bumps an obstacle" was the
    pivot-then-goal-pulls-back oscillation. New escape commits: reverse -> pivot
    -> DRIVE FORWARD (COMMIT_TIME_S, ignoring the goal) to actually clear the
    obstacle before re-seeking the goal; re-escapes the OTHER way if a fresh
    obstacle appears mid-commit; alternates turn direction on repeats (breaks a
    trap); used by both the proximity recov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
    [main_window.py, robot2_local_nav.py]
2026-06-18 SCAN: simpler, wall-clear coverage paths; ASCII widgets; Beta cam on Alpha
    SCAN "very complex paths" + stuck-immediately fixes (coverage.py):
    - Erode the free space by the robot's clearance so NO waypoint lands against
    a wall/obstacle (the "sensor right next to it" stall); unknown cells count
    as blocked (never aim into unmapped space).
    - Use each row's LARGEST open run so a sweep never routes across a gap.
    - CAP complexity: auto-widen lane spacing to keep the path under
    max_waypoints (14) — a simple handful of sweeps, not 34 full-width passes
    the robot can't follow. Lanes default coarser (0.6 m).
    UI: stripped the emoji/box-glyphs from the AUTONOMY widget (buttons, status,
    log) to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
    [fire_panel.py, main_window.py]
2026-06-18 SCAN follows the path loosely — skip unreachable waypoints, don't trap
    "Don't follow paths too rigidly so it doesn't get stuck in a dead end": the
    mission executor gains a skip_stuck mode. A waypoint not reached in wp_timeout
    is SKIPPED (advance to the next) instead of aborting/grinding 25 s — so a
    dead-end waypoint never traps the coverage scan. Looser 'close enough' tol
    (0.45 m) so it isn't rigid about exact points. Gives up only after MAX_SKIPS
    (4) consecutive unreachable waypoints. SCAN runs skip_stuck=True, wp_timeout
    12 s; FIRE/goto stay precise (must actually reach the fire).
    [main_window.py, mission.py]
2026-06-18 SCAN: progress-based stuck detection (don't skip far-but-reachable waypoints)
    Field: Beta "STOPPED (stuck)" in the open with nothing in front — the skip
    timer was TIME-based, so on a big map it couldn't cross to a waypoint metres
    away within 12 s and skipped 4 reachable ones in a row -> false "stuck". Now a
    waypoint is only skipped when Beta stops getting CLOSER to it (no progress for
    the timeout), so a distant waypoint it's still approaching is never skipped;
    only a genuinely blocked one is. Same logic guards FIRE/goto aborts.
    [mission.py]
2026-06-18 docs/memory: summarize the autonomy demo build (SCAN + FIRE)
    Runbook + redacted memory snapshot + CLAUDE.md updated with the AUTONOMY dock
    (SCAN coverage of Alpha's map + GO TO FIRE -> pump 5s -> return), the
    coverage-path generator (eroded clearance, largest-run, capped), loose
    progress-based path following, the commit-forward escape, faster auto
    rotation, the encoder-heading fallback, and the UI changes (ASCII widgets,
    Beta-camera fallback on Alpha). No secrets.
2026-06-19 docs: graduation book overhaul + reference/visual plans + team task board
    Adds the corrected, humanized, professionally formatted graduation book and all
    supporting deliverables so the team can finish it.
    - Book: CORRECTED.docx/.pdf (final) + FORMATTED.docx/.pdf (original baseline)
    - docs/book_corrections/: per-chapter audit + 125 factual corrections w/ evidence
    - docs/humanize_chunks/ + humanize_plan.md: AI-text reduction workflow (~5%)
    - docs/citations/: 14 verified references + placement map + Mendeley how-to
    - docs/visuals/visual_plan.md: ~25 diagram/chart specs with paste-ready prompts
    - docs/book_images/: extracted/organized figures + placeholders + audit
    - docs/DOCUMENTATION_STATUS.m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
    [apply_book_edits.py, apply_round2.py, apply_round3.py, edits_ch1.py, edits_ch2.py, edits_ch3.py, edits_ch4.py, edits_ch5.py]
2026-06-20 docs: integrate 30 generated figures into the graduation book
    - Replace weak figures 3.2/3.5/3.6 with new architecture/software/dashboard diagrams
    - Insert 27 new diagrams/charts/infographics at their sections (37 figures total)
    - Renumber all figures per chapter by position; remap in-text references
    - Rebuild List of Figures; recompute TOC/LoF/LoT page numbers (123 pp)
    - Add figures_png/ + figures_SVG/ sources and book_build/{place_figures,rebuild_lof}.py
    Completes #4 and #7.
    [place_figures.py, rebuild_lof.py]
2026-06-20 SCAN: fix autonomous coverage getting stuck (sim-surfaced, 2 real-Beta fixes)
    Hunting a sim SCAN that stopped "with nothing in front of it" turned up five
    issues; two change real Beta's behaviour, both improvements.
    Real-robot (shared code):
    - local_nav_math.goal_fusion: gate forward speed on the MORE-OPEN side
    (min closeness), not the nearest wall. A wall on one side (a doorway, or
    driving alongside a wall) no longer freezes the robot in a potential-field
    local minimum -- it keeps moving and steers clear. Forward stops only when
    BOTH sides are blocked. Adds test_one_side_open_keeps_moving.
    - mission: count TURNING toward a waypoint as progress, not just closing
    distance. The gent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
    [local_nav_math.py, main_window.py, mission.py]
2026-06-20 console: SCAN path editor, plan→START confirm, manual-assist resume, drift tolerance
    Operator-driven autonomy improvements built + tested against the live fleet:
    - Manual ASSIST during a run (mission.pause/resume): grabbing the joystick
    mid-SCAN/FIRE now PAUSES the mission and hand-drives, then resumes from the
    robot's new pose ~1s after release instead of cancelling the whole run.
    - EDIT PATH on the map: an editable, NUMBERED waypoint skeleton — drag a node
    to move, click empty to add (splits nearest segment), right-click to remove.
    START node is green / END orange / numbers bold-dark so they read on the
    light map. SCAN then follows the edited path (A*-routed around walls).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
    [fire_panel.py, main_window.py, mission.py]
2026-06-20 nav: A* around obstacles (no straight-through), decisive turn-around, wide-open routes
    Operator-reported fixes:
    - _route_through no longer connects an un-routable node with a STRAIGHT line
    (which drove through walls). A* routes around mapped obstacles via doorways;
    a node A* genuinely can't reach is DROPPED, never plowed through. (Drift of
    the robot's own pose is still handled by plan_path's start-disc free.)
    - mission: decisive TURN-AROUND. When the next waypoint is well behind (>~80
    deg), commit to one spin direction at full rate (no driving) until facing it,
    so a ~180 deg target near the +/-pi wrap can't flip the sign and make the
    robot rock / inch back and forth instead of ju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
    [main_window.py, mission.py]
2026-06-20 docs: operator autonomy controls (SCAN plan→START, EDIT PATH, assist, routing)
    Runbook + CLAUDE.md: the plan→review/edit→START SCAN flow, draggable numbered
    node editor, manual ASSIST pause/resume, decisive turn-around, wide-open
    routing + drift tolerance, and the note that residual wall-side oscillation
    lives in the on-robot escape ladder. All console-side (no robot redeploy).
2026-06-20 CLAUDE.md: full 2026-06-20 autonomy-hardening summary (problems -> fixes)
    So any new session reads what was solved and where: the SCAN-stuck root
    causes (plan-around-walls, open-side fusion [robot-side, deployed], turning-
    counts-as-progress), the no-straight-through-objects routing, decisive turn-
    around, wide-open routing, drift tolerance, sim faithfulness, and the operator
    controls (plan->START, node editor, manual assist) — plus the standing limit
    (lidar-less drift; periodic SET POSE) and that wall-side oscillation lives in
    the on-robot escape ladder. CLAUDE.md is committed (not gitignored).
2026-06-20 tools: transfer Claude Code CLI chat history between your own machines
    claude_sessions.ps1 / .sh export|import the repo's session .jsonl transcripts
    so `claude --resume` finds them on another device. Recomputes the per-machine
    project slug (abs repo path with non-alphanumerics -> '-') instead of copying
    the folder name verbatim, so it works even when the repo path differs. The
    transcript zip is gitignored (chat history is transferred out-of-band, not
    committed).
2026-06-20 docs(using_claude_code): how to move chat history between your own machines
    New section 6 + table row: export/import the GP session transcripts with
    tools/claude_sessions.{ps1,sh} so `claude --resume` works on another device.
2026-06-20 fix: Alpha goto un-blocks (mask the crept bracket) + Beta straight-line anti-weave
    Diagnosed live on the new device:
    - ALPHA stuck on every goal: robot1_goto received goals fine but held with
    "path blocked (AHEAD/ROTATE)". Root cause: the front cable-bracket crept to
    ~0.29 m (was 0.21-0.24), landing in the dead band PAST the self-occlusion
    mask (SELF_RADIUS_BOUND 0.28) yet INSIDE stop_ahead (0.35) -> treated as a
    real obstacle. Raised SELF_RADIUS_BOUND 0.28 -> 0.33 to re-mask it. Power was
    clean (throttled=0x0). NEEDS DEPLOY TO ALPHA + restart robot1_goto (map kept
    -- SLAM is a separate node). Physical fix is still to tuck the bracket <=0.24.
    - BETA snakes left/right driving st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
    [mission.py, robot1_goto.py]
2026-06-20 video: true FPS via 1s sliding window (was showing ~344 on a 15 fps stream)
    The panel computed FPS as instantaneous 1/dt between frame arrivals. Beta's
    bursty WiFi (and clumped cross-thread signal delivery) lands frames <1 ms
    apart, which the max(1e-3,dt) clamp turned into ~1000 fps spikes the EMA
    averaged up to ~344 — while the robot actually publishes ~15 fps (measured on
    both 5560 framed and 5555 legacy). Count frames shown in the last second
    instead: burst-immune, reports the real rate. Console-only.
2026-06-20 docs(book): integrate figures into friend-edited version + fix TOC page numbers
    - Re-applied all 30 figures (37 total) to the friend's edited CORRECTED.docx
    (their Ch1 expansion + content edits preserved; no corrections/humanization re-run)
    - place_figures.py: tolerant heading anchors (handles de-numbered Ch1 headings)
    - rebuild_lof.py: boundary-aware figure/table caption page lookup
    - Recomputed all TOC/List-of-Figures/List-of-Tables page numbers, body-anchored
    (fixes entries that had pointed to the TOC page after headings lost their numbers)
    - Verified: 37 figures, 51/51 figure/table entries match captions, no fact regressions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
    [place_figures.py, rebuild_lof.py]
2026-06-20 docs(book): fix placeholder figure numbers (5.1->5.2, 5.2->5.6)
    The two Chapter-5 placeholder images had their pre-renumber figure numbers baked
    into the graphic (5.1, 5.2) while their captions are now 5.2 and 5.6. Regenerated
    the placeholders with the correct numbers and swapped them in.
    [fix_placeholders.py]
2026-06-20 beta: slower forward/back, keep rotation snappy (careful near objects)
    Operator request 2026-06-21: Beta drove too fast and could clip an object it
    sensed (lidar-less; only the two front ultrasonics). Slow the LINEAR speed,
    leave rotation high.
    - goto.max_linear_mps 0.12 -> 0.09
    - drive.auto_fwd_max_pwm 175 -> 145
    - local_nav wander_fwd 0.12 -> 0.09, wander_slow 0.07 -> 0.05, reverse 0.10 -> 0.08
    - max_angular_rps 0.35 and auto_turn_pwm 235 UNCHANGED (snappy turns).
    Slower cruise also slips the wheels less, which eases (not cures) the
    dead-reckoning drift. Deployed to Beta + robot2_local_nav restarted (lin<=0.09
    turn<=0.35 confirmed); laptop console reloaded for the streamed-bias cap.
    Co-Au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
    [robot2.yaml]
2026-06-20 mission: guided Alpha->Beta master/slave demo (operator-gated, mocked logs)
    New MASTER MISSION dock (mission_panel.py + orchestration in main_window) that
    walks the graduation demo step by step, centralized with simulated robot1->robot2
    orders in the log:
    START -> Alpha maps -> operator: MAPPING DONE -> Alpha asks to scan ->
    operator: CONFIRM -> suggested path shown for review/edit -> operator:
    START SCAN -> Beta scans + returns -> Alpha asks to send Beta to the fire ->
    operator places the FIRE (clamped INSIDE the map) + CONFIRM -> Beta drives ->
    pump 5 s -> returns -> DONE. ABORT stops everything.
    Reuses the existing SCAN (plan->review->START) and FIRE (go->pump->return)
    flows; t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
2026-06-20 beta: a little faster rotation (operator request 2026-06-21)
    goto.max_angular_rps 0.35 -> 0.42, drive.auto_turn_pwm 235 -> 248. Forward/back
    speeds unchanged. Deployed to Beta (robot2_local_nav turn<=0.42 confirmed,
    robot2_bridge restarted for the PWM cap); console reloaded for the streamed
    turn-bias.
    [robot2.yaml]
2026-06-20 mission: STEP DONE -> NEXT override (operator force-completes a step)
    Adds a third MISSION-panel button so the operator can mark the current step
    complete and advance even when Beta doesn't perfectly finish (drift / stuck) or
    to skip a step entirely. Stops the robot cleanly first when it's driving
    (scanning / fire), then advances the phase: mapping->ask_scan, scan->ask_fire,
    fire->done, etc. Keeps the demo flowing on flaky real hardware.
    [main_window.py, mission_panel.py]
2026-06-20 drive: MANUAL takes over mid-mission (pause & hold), AUTONOMOUS resumes
    Previously switching to MANUAL during a SCAN/FIRE/MISSION leg CANCELLED the run.
    Now, while a leg is active: MANUAL pauses+HOLDS the mission and disarms autonomy
    (robot won't wander; manual CMD_DRIVE still drives via the bridge), so the
    operator can freely reposition Beta (e.g. after drift); AUTONOMOUS re-arms and
    resumes the mission from the current pose. Outside a mission it's the plain
    manual/auto toggle as before. Complements the quick assist-nudge (which
    auto-resumes); MANUAL HOLD is the sustained takeover. _manual_hold cleared on
    finish/stop/reset.
    [main_window.py]
2026-06-20 figure: SLAM occupancy grid output vs. physical test environment
    book_build/make_slam_vs_env.py renders a side-by-side: (a) the SLAM occupancy
    grid in the console's real map palette (free/occupied/unknown + scan speckle,
    ragged walls, mapper trajectory, scan fan, obstacle) and (b) a clean floor-plan
    of the 4x4 m 4-room arena (walls, doorways, obstacle, Alpha/Beta/Gamma starts,
    fire, dimensions). Geometry matches build_arena; colors match ui/theme.
    Output: figures_png/slam_vs_environment.png.
2026-06-23 robot: relocate pump Beta->Alpha (10s fire action) + Beta detection buzzer
    Pump moved from Beta to Alpha: Alpha now runs go-to-fire -> pump 10 s ->
    return using its lidar goto; Beta detects the fire and keeps only the servo.
    A buzzer on Beta (Mega pin 34, 'N<n>' command) beeps twice on any camera
    detection.
    - firmware: robot1_controller_v3 gains the pump relay (D34, active-high, 10 s
    hard auto-off); robot2_controller_v5 drops the pump, adds the buzzer (D34,
    non-blocking beep train)
    - gpcore: CMD_BUZZER + mega_commands.buzzer()='N<n>'; Beta's D packet keeps a
    reserved 0 in the old pump slot so field positions don't shift
    - gateway: _h_buzzer forwards N<n> to /accessory_cmd
    - bridges: r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
    [robot1.yaml, robot2.yaml]
2026-06-23 robot3/Gamma: encoderless map odometry, motor speed control, gas buzzer at 2700
    - MAP pose without encoders: heading from the IMU (gyro-Z integrated on the
    ESP32, bias learned only when truly still so it doesn't drift back after a
    turn) + position from a calibrated drive speed x time. The laptop dead-reckons
    from the COMMANDED direction (the device's telemetry 'dir' echo is unreliable)
    and scales by the speed slider. SET POSE aligns it like Beta.
    - motor SPEED control: the Arduino now PWMs the L298N enables (ENA moved D8->D6
    for a PWM pin) at a 0..9 level the ESP relays from the console /speed slider.
    - gas buzzer/alarm threshold lowered 3000 -> 2700.
    - esp32 link gains CMD_SPEED +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
    [robot3.yaml]
2026-06-24 docs: presentation question bank (English) — full system Q&A
    Comprehensive expected-questions guide for the defense: architecture, the three
    robots, SLAM/mapping, localization & odometry, A* planning, obstacle avoidance,
    multi-robot coordination, ZMQ gateway/networking, the PySide6 console, YOLO
    detection, firmware, layered safety, the SCAN/FIRE autonomy demo, software
    engineering, challenges/trade-offs, limitations/future work, deep-dive gotchas,
    and a quick-fire spec sheet. Grounded in the repo's code/config.
2026-06-25 docs: slide-by-slide speaker notes for the final presentation
    Presenter script for all 26 slides of "Graduation project Presentation-final
    version.pdf": what's on each slide, what to say (natural spoken script),
    points to emphasize, and transitions — grounded in the real system. Includes a
    rehearsal checklist and pointers to the question bank (presentation_qa.md).
